MiroslavMitrovic/DashDataDisplay_STM32/Design/PressureSensorTestingAndMeasurements.jpg

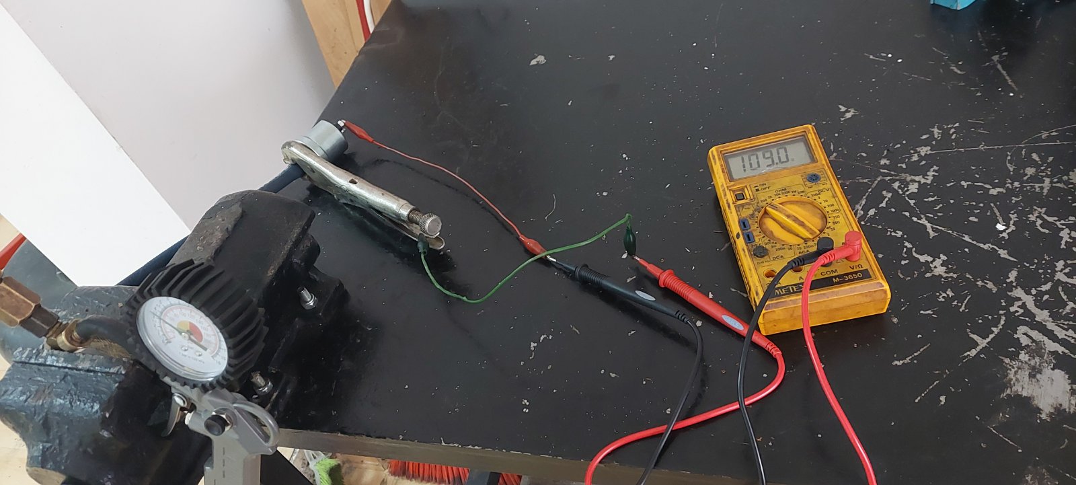
Design/PressureSensorTestingAndMeasurements.jpg
