MiroslavMitrovic/DashDataDisplay_STM32/Hardware/DashDataDisplay/Project Outputs for DashDataDisplay/Net Status - DashDataDisplayPCB.html

Altium customize

# Net Status Report

Date: | | 6/19/2024
Time: | | 10:40:57
Elapsed Time: | | 00:00:01
Filename: | | D:\Projects\git\STM\DashDataDisplay_STM32\Hardware\DashDataDisplay\DashDataDisplayPCB.PcbDoc
Units: | | mmmils

Nets | Layer | Length
+5 | Signal Layers Only | 538.537mm
GND | Signal Layers Only | 1146.7674mm
NetC102_2 | Signal Layers Only | 10.0178mm
NetC112_2 | Signal Layers Only | 10.9581mm
NetC122_2 | Signal Layers Only | 9.4844mm
NetC12_2 | Signal Layers Only | 12.2366mm
NetC132_2 | Signal Layers Only | 22.3811mm
NetC152_2 | Signal Layers Only | 3.0875mm
NetC215_1 | Signal Layers Only | 9.7537mm
NetC225_1 | Signal Layers Only | 34.9349mm
NetC22_2 | Signal Layers Only | 8.9749mm
NetC235_2 | Signal Layers Only | 112.516mm
NetC32_2 | Signal Layers Only | 12.539mm
NetC35_1 | Signal Layers Only | 27.2767mm
NetC37_1 | Signal Layers Only | 128.4952mm
NetC37_2 | Signal Layers Only | 65.4609mm
NetC42_2 | Signal Layers Only | 8.9085mm
NetC45_1 | Signal Layers Only | 23.3635mm
NetC47_1 | Signal Layers Only | 83.8395mm
NetC47_2 | Signal Layers Only | 81.1876mm
NetC52_2 | Signal Layers Only | 12.5202mm
NetC55_1 | Signal Layers Only | 9.926mm
NetC62_2 | Signal Layers Only | 8.3312mm
NetC72_2 | Signal Layers Only | 184.9554mm
NetC75_1 | Signal Layers Only | 41.1927mm
NetC82_2 | Signal Layers Only | 155.3025mm
NetC92_2 | Signal Layers Only | 9.3946mm
NetD11_1 | Signal Layers Only | 3.7163mm
NetD16_1 | Signal Layers Only | 2.9565mm
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
NetU15_16 | Signal Layers Only | 63.1158mm
NetU15_17 | Signal Layers Only | 57.4768mm
NetU15_18 | Signal Layers Only | 92.7663mm
NetU15_33 | Signal Layers Only | 153.1815mm
VBAT | Signal Layers Only | 265.9646mm
VCC | Signal Layers Only | 666.7312mm

Back to top
