MiroslavMitrovic/DashDataDisplay_STM32/Design/ArchitectureDiagrams/HWLayoutSystemDeploymentDiagram.pdf

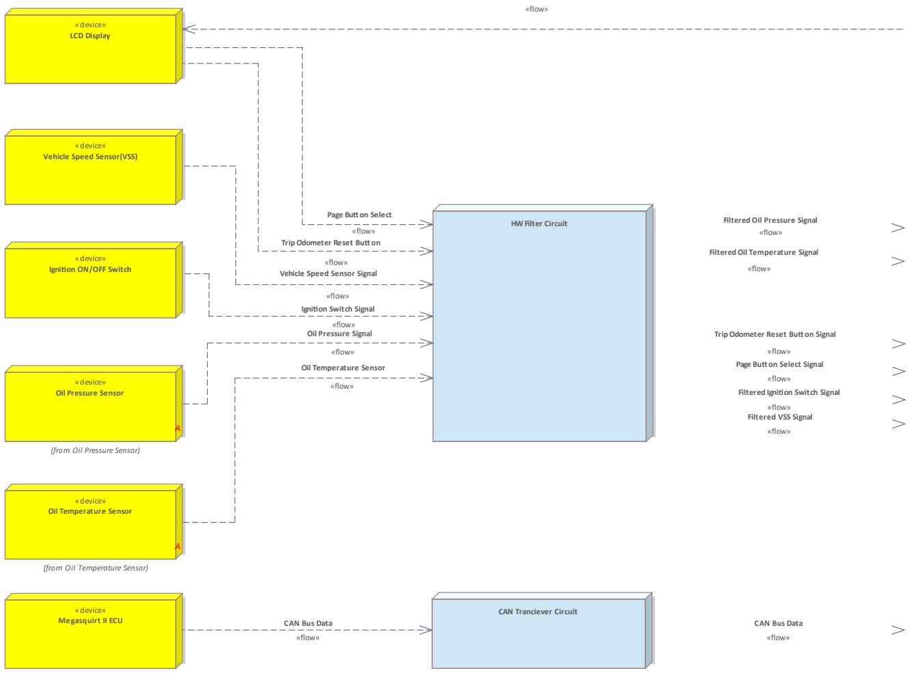
[picture p8: figure]
«device» LCD Display; «device» Vehicle Speed Sensor(VSS); «device» Ignition ON/OFF Switch; «device» Oil Pressure Sensor; (from Oil Pressure Sensor); «device» Oil Temperature Sensor; (from Oil Temperature Sensor); «device» Megasquirt II ECU; HWFilter Circuit; CAN Tranciever Circuit; CAN Bus Data «flow»; Oil Pressure Signal; «flow»; TripOdometer Reset Button; Ignition Switch Signal; Filtered Ignition Switch Signal «flow»; FilteredOil Pressure Signal «flow»; Page Button Select; FilteredOil Temperature Signal; Filtered VSS Signal «flow»; Page Button Select Signal «flow»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

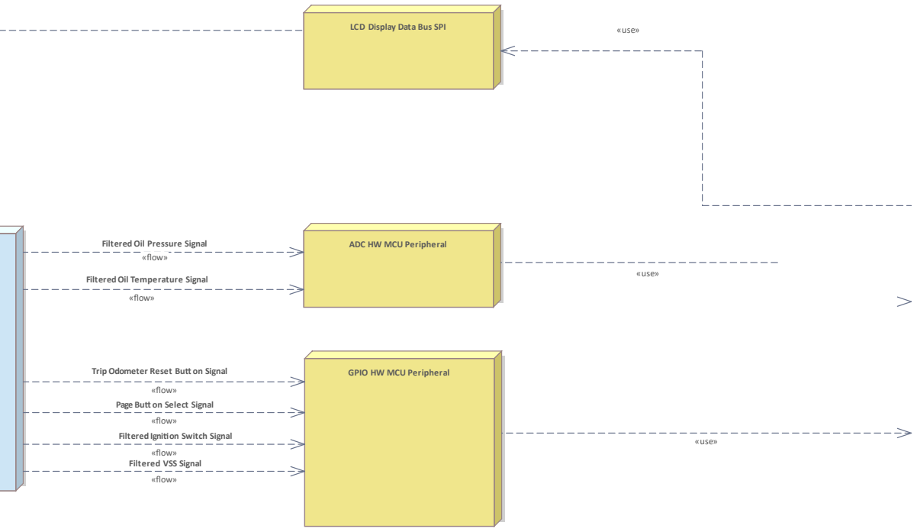
[picture p9: figure]
ADC HW MCU Peripheral; GPIO HW MCU Peripheral; LCD Display Data Bus SPI; «use»; Filtered Ignition Switch Signal «flow»; FilteredOil Pressure Signal «flow»; FilteredOil Temperature Signal; «flow»; Filtered VSS Signal «flow»; Page Button Select Signal «flow»; TripOdometer Reset Button Signal

CAN HW MCU peripheral; CAN Bus Data «flow»; CAN Bus Data «use»
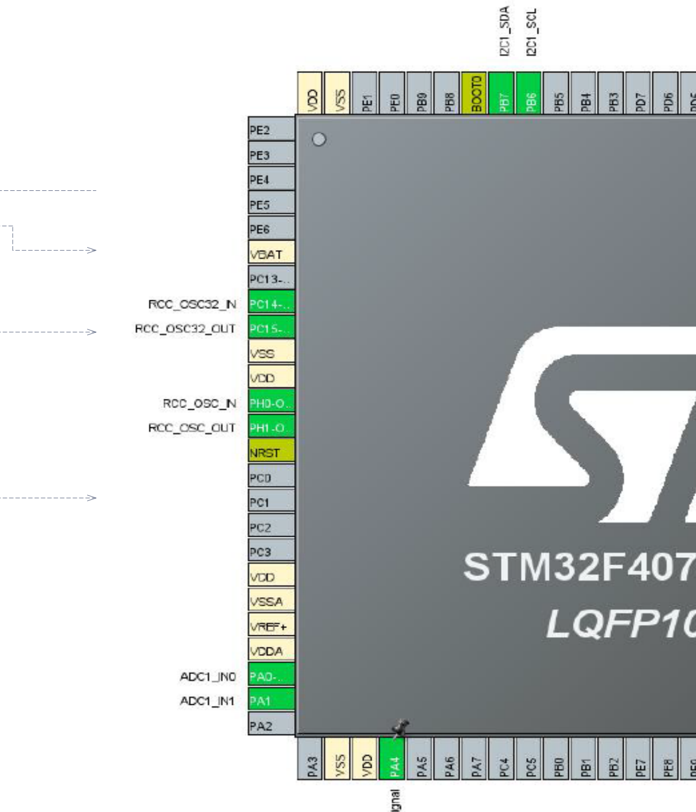
[picture p10: page 3]
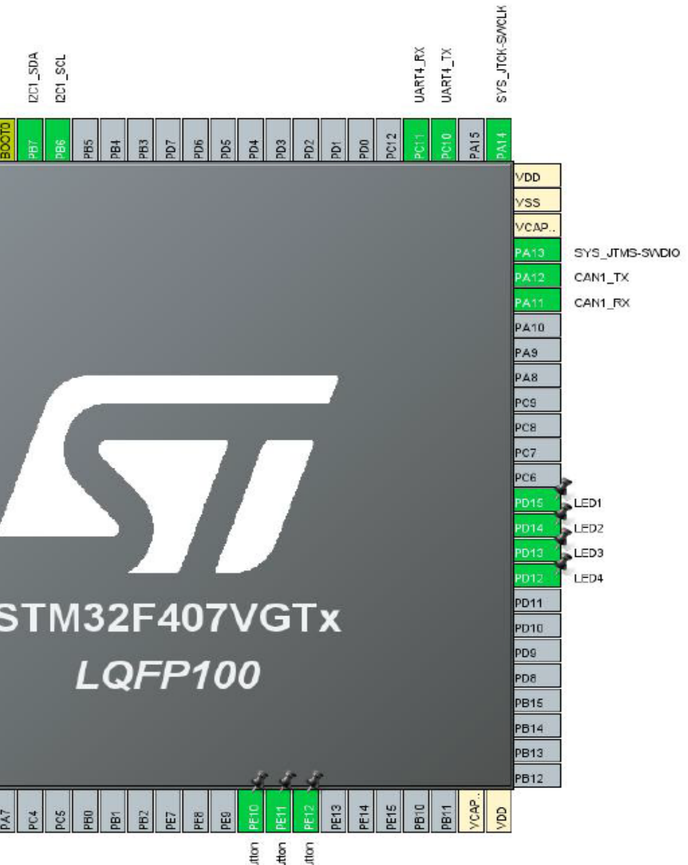
[picture p11: page 4]

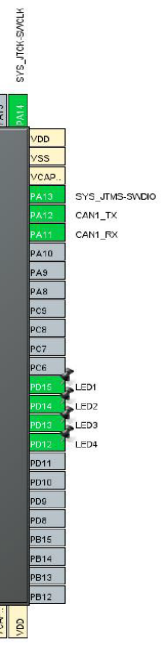
[picture p12: figure]

Legend :
Gold color is for external Components Bluecolor is for external HW peripheral circuits Yellowcolor is for internal MCUHW Peripherals

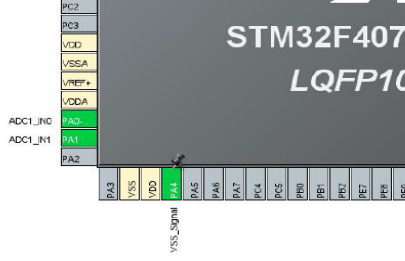
[picture p13: figure]

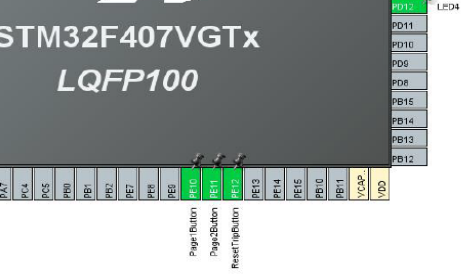
[picture p14: figure]
