MiroslavMitrovic/DashDataDisplay_STM32/Hardware/DashDataDisplay/02_Docs/Connector/ENG_SS_408-3284_A.pdf

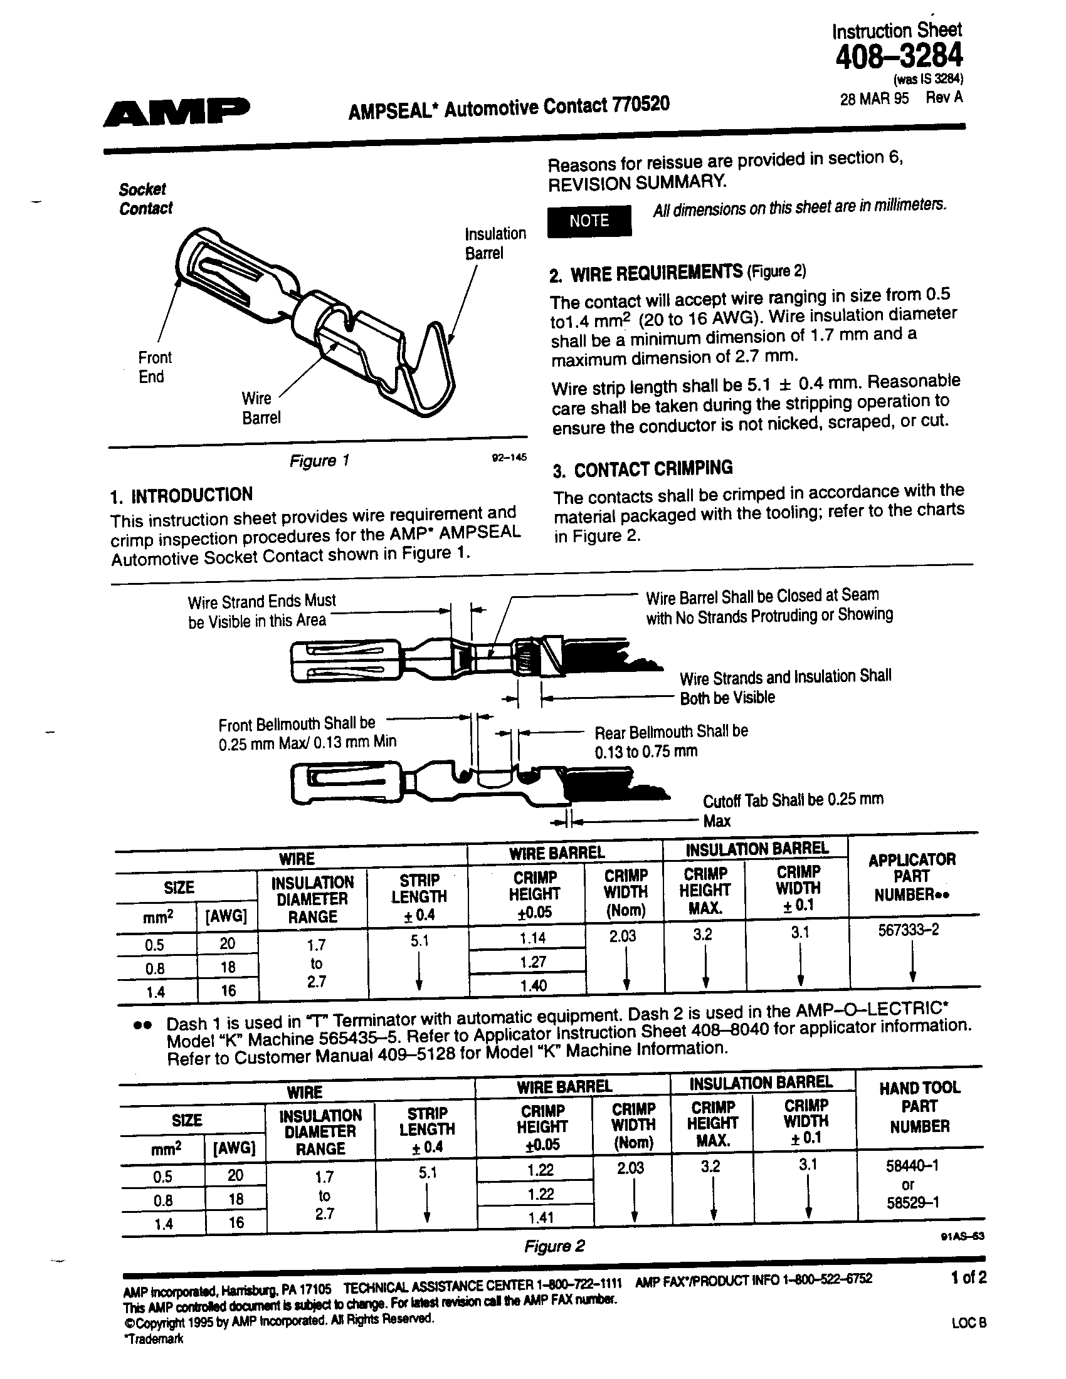
[picture p20: page 1]
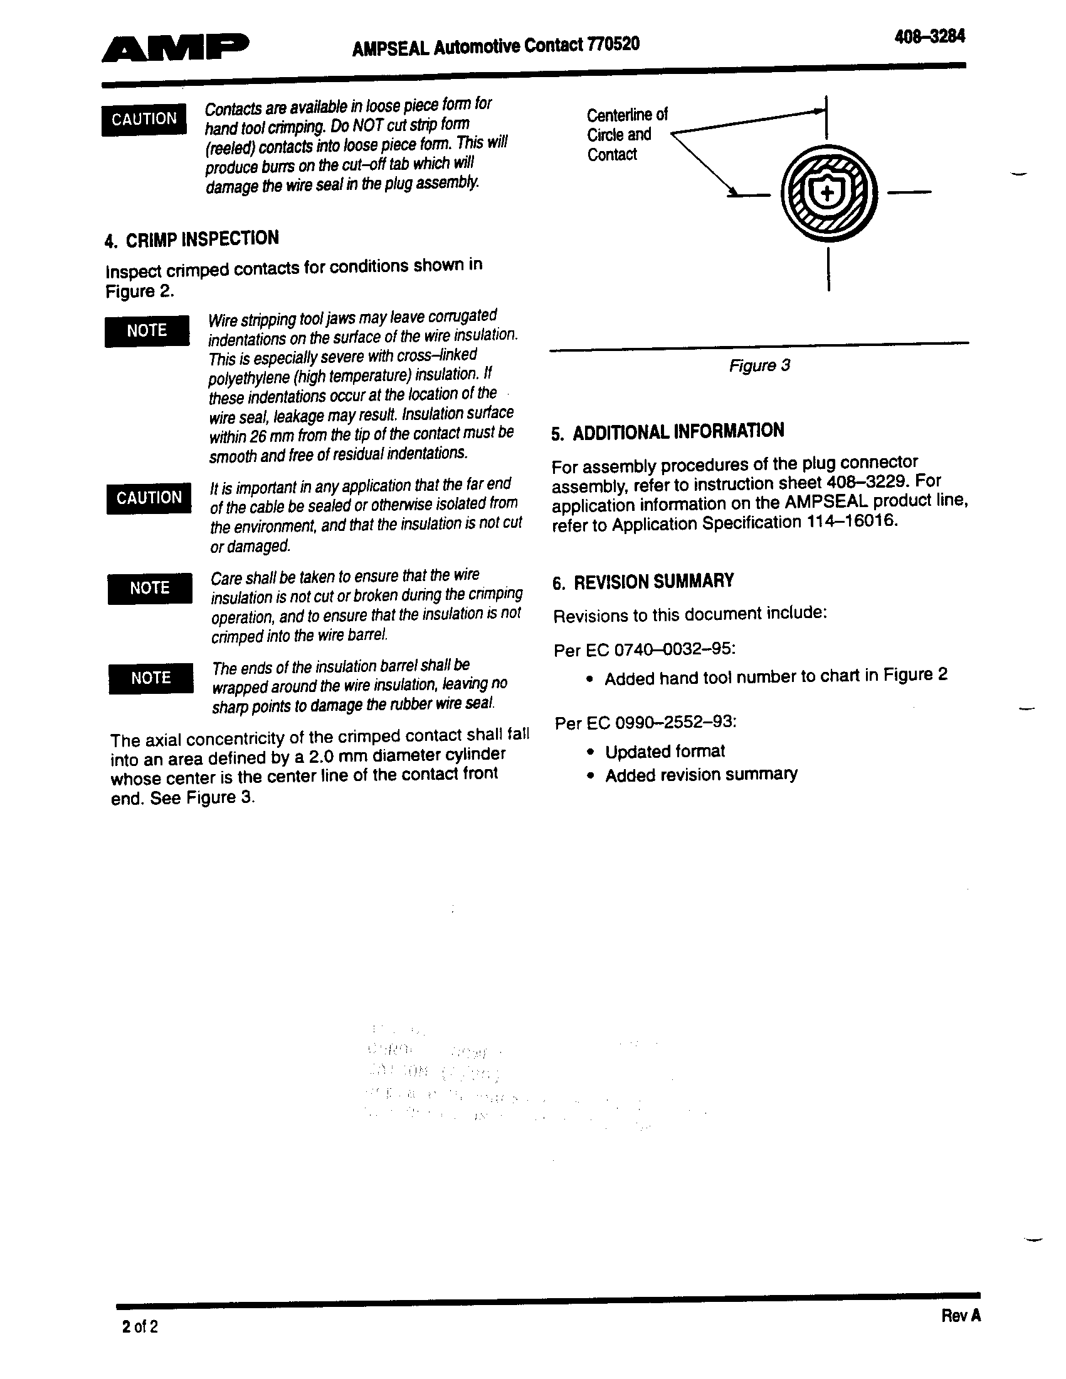
[picture p21: page 2]
