MiroslavMitrovic/DashDataDisplay_STM32/Design/0261230365_bosch_oil_pressureSensor.jpg

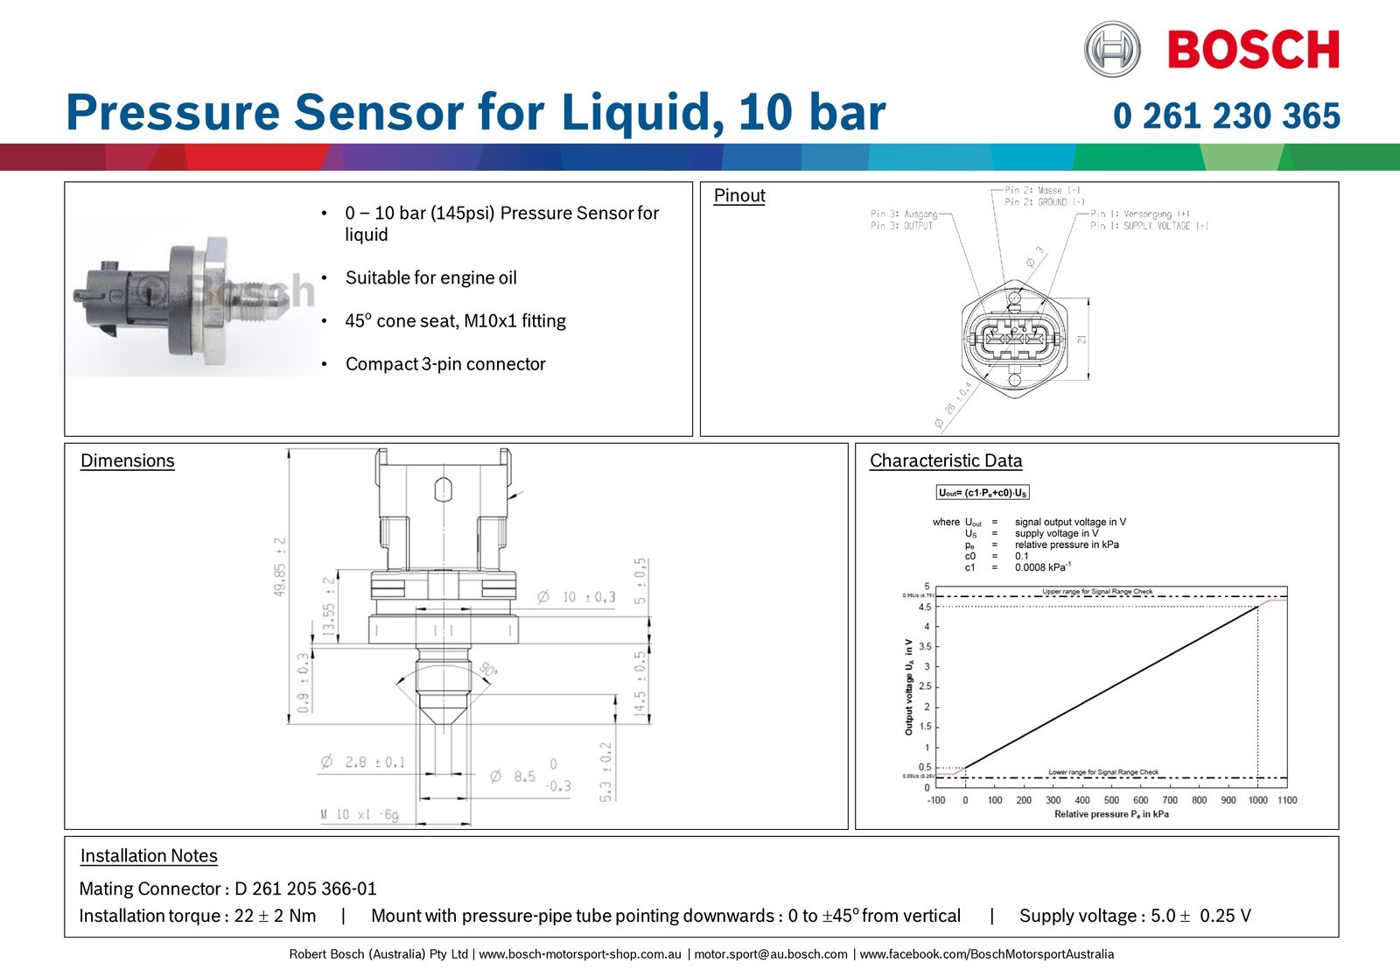
Design/0261230365_bosch_oil_pressureSensor.jpg
