MiroslavMitrovic/DashDataDisplay_STM32/Design/ArchitectureDiagrams/DashDataDisplay_FileStructureDiagram.png

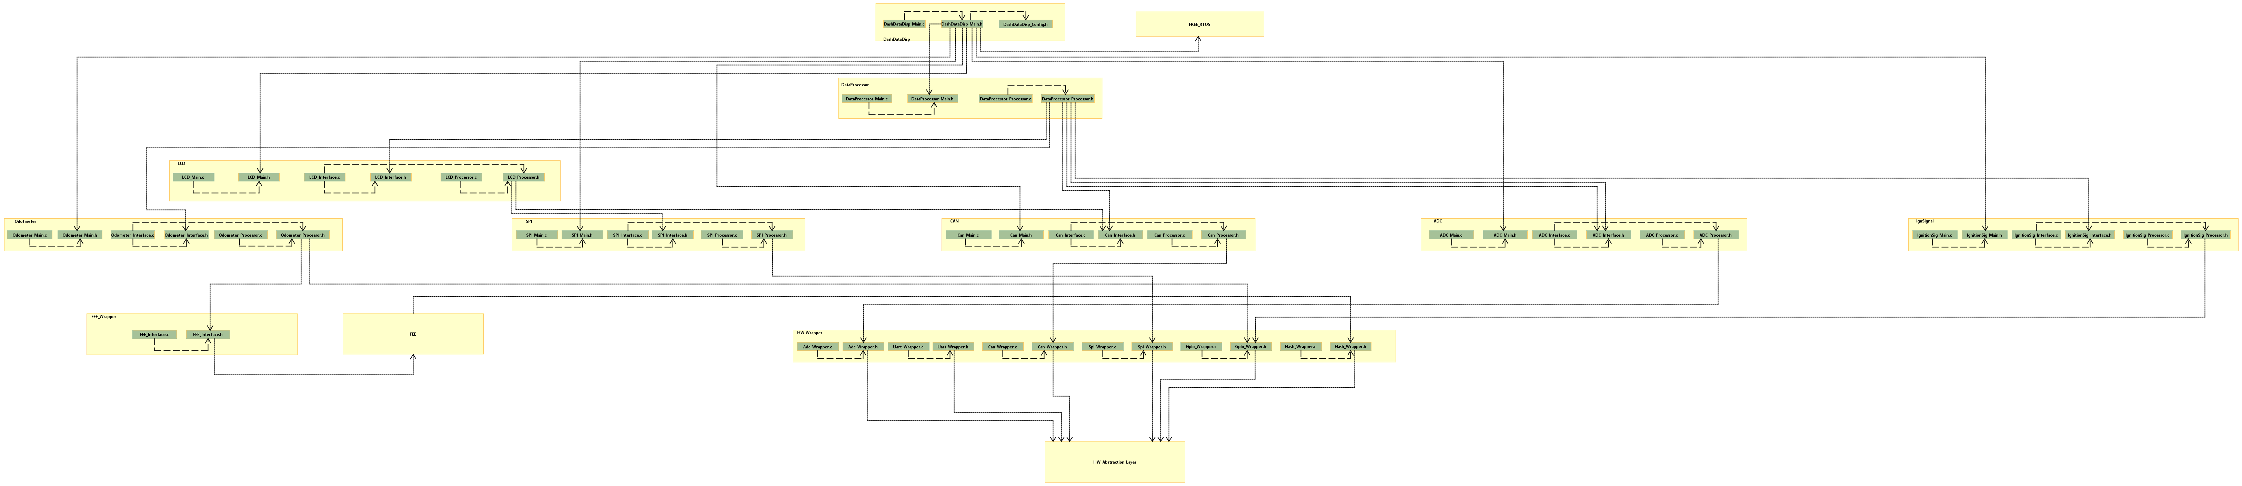
Design/ArchitectureDiagrams/DashDataDisplay_FileStructureDiagram.png
