MiroslavMitrovic/DashDataDisplay_STM32/Design/ArchitectureDiagrams/DashDataDisplay_HW_LayoutSystemDiagram.png

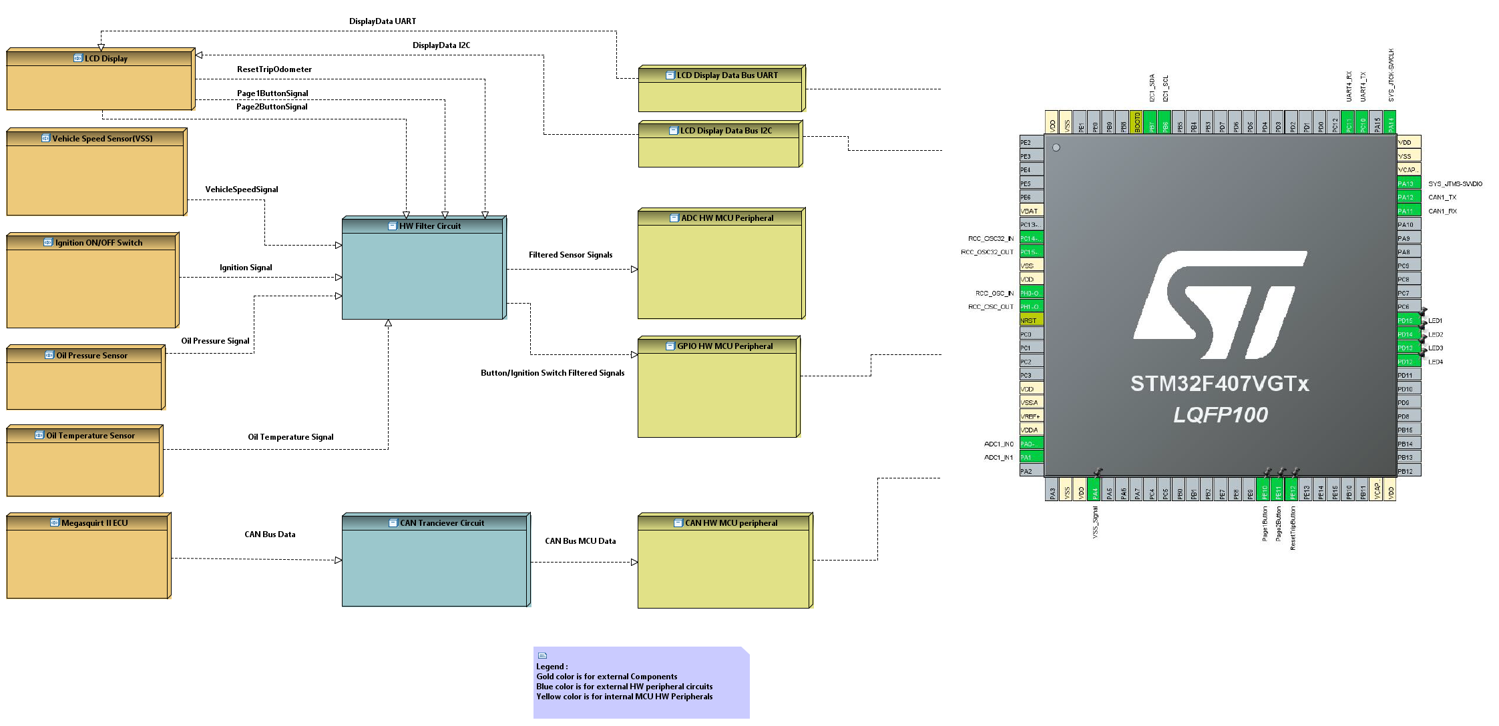
Design/ArchitectureDiagrams/DashDataDisplay_HW_LayoutSystemDiagram.png
