MiroslavMitrovic/DashDataDisplay_STM32/Design/ArchitectureDiagrams/DashDataDisplay_MCUPinLayout.PNG

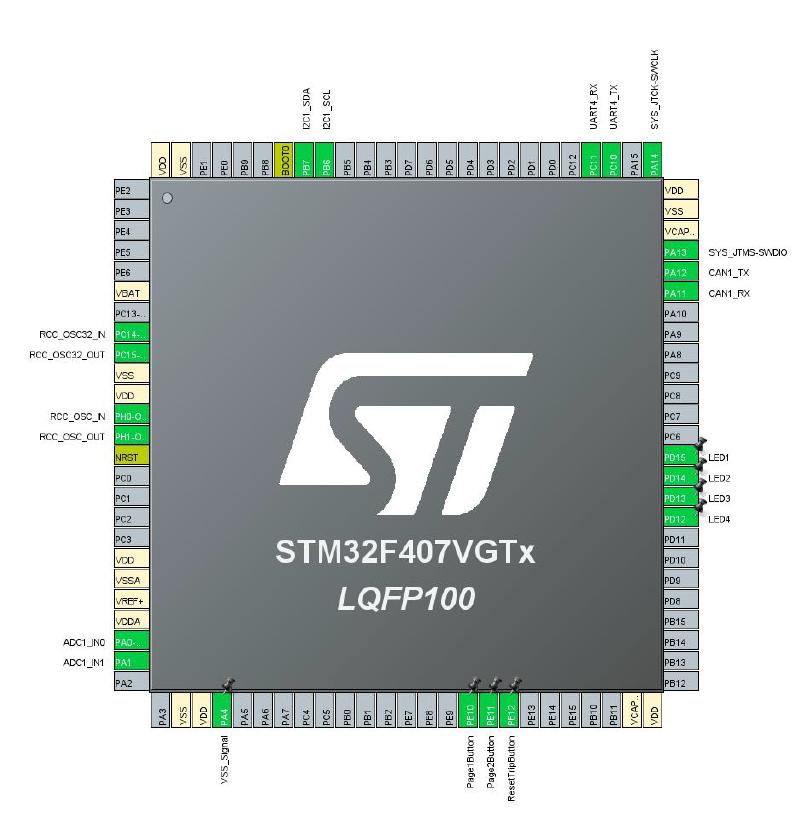
Design/ArchitectureDiagrams/DashDataDisplay_MCUPinLayout.PNG
