MiroslavMitrovic/DashDataDisplay_STM32/Design/ArchitectureDiagrams/ThermistorCalculator.png

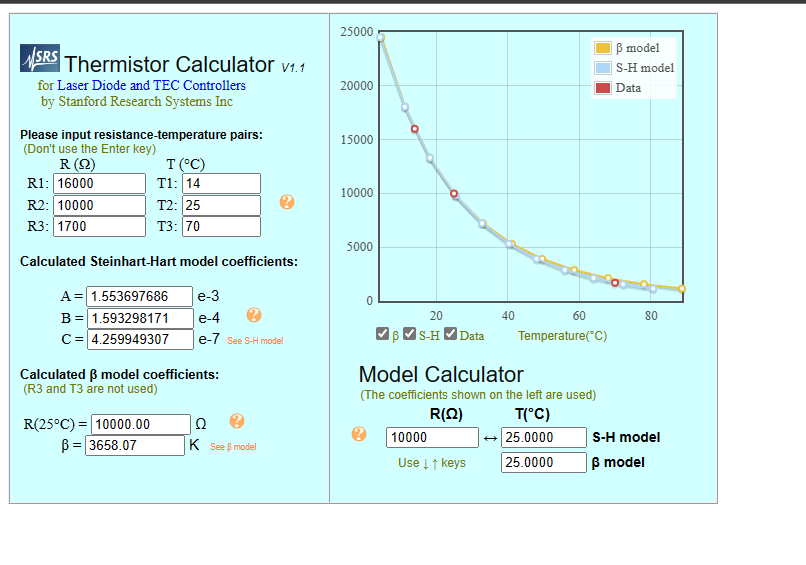
Design/ArchitectureDiagrams/ThermistorCalculator.png
