MiroslavMitrovic/DashDataDisplay_STM32/Design/ArchitectureDiagrams/ThermocoupleInterfacingCircuit.png

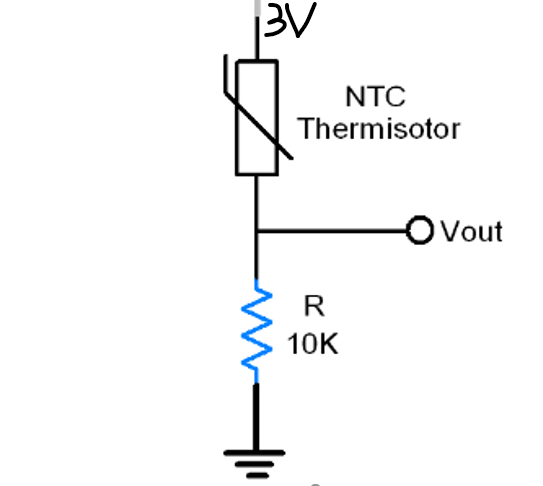
Design/ArchitectureDiagrams/ThermocoupleInterfacingCircuit.png
