MiroslavMitrovic/DashDataDisplay_STM32/Design/NTCcircuitDrawing.png

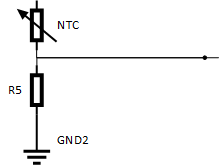
Design/NTCcircuitDrawing.png
