MiroslavMitrovic/DashDataDisplay_STM32/Design/PressureSensorcircuitDrawing.png

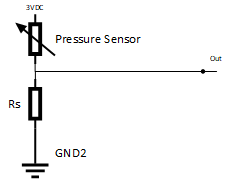
Design/PressureSensorcircuitDrawing.png
