MiroslavMitrovic/DashDataDisplay_STM32/Hardware/DashDataDisplay/02_Docs/MCU/en.mb997_bom/mb997_bom/MB997_B02/MB997-F407VGT6-B02_BOM.xls

MB997 BOM
NO | Code | Part Number | Manufacturer | Description | Designator | Quantity | Process | Note
1 | SQC0001 | TD0341X-G01-BLU | wealthmetal | on-off,Touch switch,Blue,Square head,6*6,SMT,180Degree，TD-0341X-GO1,wealthmetal | B1 | 1 | SMT
2 | AKG0002 | PB-512 Blue | szalong | Button hat,Blue，MB672 | B1-1 | 1 | ASS
3 | SQC0002 | TD0341X-G01-BLA | wealthmetal | open/off,Touch switch,Black,Square head,6*6,SMT,180Degree，TD-0341X-GO1,wealthmetal | B2 | 1 | SMT
4 | AKG0003 | PB-512 Black | szalong | Button hat,Black，MB672 | B2-1 | 1 | ASS
5 | CCC0201 | CC0603KRX7R9BB223 | YAGEO | Capacitance,22nF,10%,50V,X7R,0603 | C54,C55 | 2 | SMT
6 | CCC0008 | CC0603JRNPO9BN151 | YAGEO | Capacitance,150pF,0603,50V,5%,NPO | C46,C48 | 2 | SMT
7 | CCC0100 | CC0603KRX5R5BB106 | YAGEO | Capacitance,10uF,0603,6.3V,20%,X5R | C58 | 1 | SMT
9 | CCC0149 | CC0402JRNPO9BN200 | YAGEO | Capacitance,20pF,5%,50V,NPO,0402,YAGEO | C6,C9 | 2 | SMT
10 | CCC0009 | CC0603KRX5R7BB105 | YAGEO | Capacitance,1uF,0603,16V,10%,X5R,YAGEO | C1,C3,C17,C20,C28,C44,C47,C50,C51,C56,C57 | 11 | SMT
11 | CCC0001 | CC0603KRX7R9BB103 | YAGEO | Capacitance,10nF,0603,50V,10%,X7R,YAGEO; | C5,C13,C52 | 3 | SMT
12 | CCC0049 | CC0603JRNPO9BN200 | YAGEO | Capacitance,20pF,5%,50V,NPO,0603,YAGEO | C14,C15 | 2 | SMT
13 | CTD0045 | TAJA105K016R | AVX | Tantalum capacitor,1uF,10%,16V,typeA,AVX | C22,C23,C59 | 3 | SMT
15 | CTD0004 | TAJA475K016R | AVX | Tantalum capacitor,4.7uF,10%,16V,A tpy,AVX | C49 | 1 | SMT
16 | JEJ0002 | ST-225-02 | townes | Earphone jack，Black，90Degree，Side insert，ST-225-02,wealthmetal; | CN4 | 1 | DIP
17 | JPZ0015 | 313140S212116 | LWCONN | Row,2.54mm,1*6,L=11.6,180Degree,1UGold,DIP,LWCONN | CN2 | 1 | DIP
18 | JPZ0015 | 313140S212116 | LWCONN | Row,2.54mm,1*4,L=11.6,180Degree,1UGold,DIP,LWCONN | CN3 | 1 | DIP
19 | JUS0021 | MUSB5QS-BM1H6-NLB-E | townes | USB,MUSB5QS-BM1H6-NLB-E,townes | CN1 | 1 | SMT
20 | JUS0008 | 47590-0001 | Molex | Socket,USB-AB,47590-0001,SMT,MOLEX,MB784 | CN5 | 1 | SMT
21 | JPZ0033 | 313140S212145 | LWCONN | Row,2.54mm,1*2P,180Degree,L=14.5,1UGold,DIP,LWCONN；High temperature resistant，PA-9T | JP2,JP3 | 2 | SMT
22 | JPZ0015 | 313140S212116 | LWCONN | Row,2.54mm,1*2P,L=11.6,180Degree,1UGold,DIP,LWCONN | JP1 | 1 | DIP
23 | LCZ0006 | FCM1608KF-601T03 | Tai-tech | bead,600R,350mA,0603,FCM1608KF-601T03,Tai-tech | L1 | 1 | SMT
24 | DLD0028 | 19-213SY6C/S530-E2/TR8LED | EVERLIGHT | LED,Green,0603 | LD4,LD7 | 2 | SMT
25 | DLD0030 | 19-217/S2C-AM2N2VY/3T | EVERLIGHT | LED,Orange,0603 | LD3 | 1 | SMT
26 | DLD0027 | 19-213-R6C-AP1Q2B-3T | EVERLIGHT | LED,Red,0603 | LD2,LD5,LD8 | 3 | SMT
27 | DLD0029 | 19-217/BHC-ZL1M2RY/3T | EVERLIGHT | LED,Blue,0603, | LD6 | 1 | SMT
28 | DLD0032 | Avago,HSMF-A201-A00J1 | EVERLIGHT | LED,Red-green，3.2 mm x 2.8 mm,SMT, | LD1 | 1 | SMT
29 | JPZ0052 | 313250S212145 | LWCONN | Row,2.54,2*25/L=14.5/180Degree,1uGold,MB997 | P1,P2 | 2 | SMT
30 | RRC0234 | RC0603FR-0751RL | YAGEO | Resistance,51R,0603,1%，YAGEO | R61,R62 | 2 | SMT
32 | RRC0359 | RC0402FR-07100KL | YAGEO | Resistance，100K,0402,1% | R7,R8,R18,R44,R52 | 5 | SMT
33 | RRC0146 | RC0603FR-071K2L | YAGEO | Resistance,1.2K,0603,1% | R54 | 1 | SMT
34 | RRC0123 | RC0402FR-07100RL | YAGEO | Resistance,100R,0402,1%，YAGEO | R3,R4,R38,R47,R53,R69 | 6 | SMT
 | RRC0034 | RC0603FR-07100RL | YAGEO | Resistance,100R,0603,1% | R68 | 1 | SMT
35 | RRC0080 | RC0603FR-07220KL | YAGEO | Resistance,220K,0603,1% | R39 | 1 | SMT
36 | RRC0055 | RC0603FR-07510RL | YAGEO | Resistance,510R,0603,1% | R30,R32,R40 | 3 | SMT
37 | RRC0041 | RC0603FR-07680RL | YAGEO | Resistance,680R,0603,1% | R36,R41,R42 | 3 | SMT
38 | RRC0128 | RC0402FR-0722RL | YAGEO | Resistance,22R,0402,1%，YAGEO | R12,R15,R16,R17,R58,R60 | 6 | SMT
39 | RRC0130 | RC0402FR-074K7L | YAGEO | Resistance,4.7K,0402,1% | R19,R20,R29,R33 | 4 | SMT
40 | RRC0126 | RC0402FR-071KL | YAGEO | Resistance,1K,0402,1% | R14 | 1 | SMT
41 | RRC0223 | RC0402FR-071K5L | YAGEO | Resistance,1.5K,0402,1%，YAGEO | R9,R37 | 2 | SMT
43 | RRC0014 | RC0603FR-07220RL | YAGEO | Resistance,220R,0603,1% | R24 | 1 | SMT
44 | RRC0258 | RC0603FR-0747RL | YAGEO | Resistance,47R,0603,1%，YAGEO | R23 | 1 | SMT
45 | RRC0540 | RC0603FR-07620RL | YAGEO | Resistance，620R,0603,1% | R67 | 1 | SMT
46 | RRC0313 | RC0402FR-0747KL | YAGEO | Resistance,47K,0402,1% | R51,R56 | 2 | SMT
47 | RRC0065 | RC0603FR-07330RL | YAGEO | Resistance,330R,0603,1% | R66,R35 | 2 | SMT
49 | XWY0022 | HC-49S-C20QSA-8.000MHZ | jfvny | Crystal oscillator，8M，20PF，20PPM,-10-70Degree,DIP,HC-49S | X1,X2 | 2 | DIP
50 | QSJ0002 | MMBT9013 | unisonic | Triode,MMBT9013L,SOT-23,unisonic | T1 | 1 | SMT
51 | UIC0119 | CS43L22 | Cirrus | IC,DAC,CS43L22-CNZ,QFN-40,Cirrus Logic Inc | U7 | 1 | SMT
52 | ST-DEJ0010 | BAT60JFILM | ST | Diode,BAT60JFILM,SOD323/A,ST,(X3 Code 9151097) | D1,D2,D3 | 3 | SMT
53 | ST-UIC0571 | MP45DT02 | ST | IC,MP45DT02 | U9 | 1 | SMT
54 | ST-UIC0051 | LIS302DL | ST | IC,Motion sensor,LIS302DL,LGA14(3*5),ST,(X3 Code 9177944) | U5 | 1 | SMT
55 | ST-UIC0107 | STM32F103C8T6 | ST | IC,STM32F103C8T6(2-2),48-LQFP,ST,(X3 Code9175981) | U2 | 1 | SMT
56 | ST-UIC0036 | LD3985M33R | ST | IC,3.3V,LD3985M33R,SOT23-5L,ST,(X3 Code 9176161) | U1 | 1 | SMT
57 | ST-UIC0572 | LD3985M25R | ST | IC,LD3985M25R,SOT23-5L,ST | U3 | 1 | SMT
58 | ST-UIC0573 | STM32F407VGT6 | ST | IC,STM32F407VGT6 | U4 | 1 | SMT
59 | ST-UIC0095 | STMPS2141STR | ST | IC,STMPS2141STR,SOT23-5,ST,(X3 Code9159003) | U6 | 1 | SMT
60 | ST-UIC0063 | EMIF02-USB03F2 | ST | IC，EMIF02-USB03F2，flip ship，ST,(X3 Code 9179037) | U8 | 1 | SMT
61 | A01D028 | PCB MB997 | FASTPRINT | PCB,MB997 |  | 1 | SMT
62 | ADL0002 | 316102S111A | LWCONN | Short circuit at,2.54MM,开口,1UGold,LWCONN；Harwin,M7566-05/M7571-05 |  | 5 | ASS
63 | PKZ0015 | insert card |  | Paper jam，MB997 B-02 The new version of ST color card |  | 1 | ASS
64 | PXS0007 | Blister |  | Plastic box,MB997 400*140MM PET 0.5MM |  | 1 | ASS
65 | PSD0001 | label |  | Label，White background，6mm,8m |  | 1 | ASS
70 | PBQ0016 |  |  | Test label，Step T1,T2,T3,T4,QA,Look at the objects |  | 1 | ASS
71 | PZX0006 |  |  | Box，L620*425*310mm，MB672 Big box |  | 1/180 | 包装
8 | CCC0071 | CC0402KRX7R7BB104 | YAGEO | Capacitance,100nF,10%,16V,X7R,0402，YAGEO | C2,C4,C7,C8,C10,C11,C12,C18,C19,C21,C24,C25,C26,C29,C30,C31,C32,C34,C35,C37,C39,C40,C41,C42,C43,C45,C53,C60 | 28 | SMT | C38 not Fitted 2011-8-24
14 | CCC0135 | CC1206KKX7R7BB225 | YAGEO | Capacitance,2.2uF,10%,16V,X7R,1206 | C33,C36 | 2 | SMT | modified TAN-A to 1206，2011-11-11 sunnash
31 | RRC0124 | RC0402FR-0710KL | YAGEO | Resistance,10K,0402,1%，YAGEO | R5,R6,R13,R31,R34,R43,R45 | 7 | SMT | R64 not Fitted 2011-8-24
42 | RRC0030 | RC0603JR-070RL | YAGEO | Resistance,0R,0603,5%,YAGEO | R1,R10,R11,R21,R22,R25,R26,R28,R46,R48,R50,R55,R59,R65 | 14 | SMT | delete R27,add R28,2012-1-6
48 | RRC0220 | RC0402JR-070RL | YAGEO | Resistance,0R,0402,5%，YAGEO | SB1,SB3,SB5,SB7,SB9,SB11,SB12,SB15,SB16,SB18,SB19,SB20,R63 | 13 | SMT | R63 modified to 0R，0402 2011-8-24
