MiroslavMitrovic/DashDataDisplay_STM32/Hardware/DashDataDisplay/02_Docs/MCU/en.mb997_bom/mb997_bom/MB997_D01/MB997-F407VGT6-D01_BOM.xls

Sheet: BOM Report
Bill of Materials |  |  |  | STMicroelectronics
Project: |  | STM32F407G-DISC1
Board Name |  | MB997
Board Version |  | D-01
Variant: |  | None
Creation Date: | 11/6/2015 | 11:05:01 AM
Print Date: | 2015-11-06 | 11:06:12
Comment | Description | Designator | Fitted | Solder | Footprint | Manuf_1 | Manuf_Part_1 | Quantity
SW-PUSH-CMS | Non-Open Push-Button 0.1A 24V | B1, B2 |  |  | BP1CMS | FARNELL | 535-930 | 2
1µF_X5R_0603 | 0603 X5R 1µF | C1, C3, C17, C20 |  |  | 0603C |  |  | 4
100nF | Capacitor | C2, C4, C18, C19, C21, C24, C25, C26, C29, C30, C31, C32, C34, C35, C37, C38, C60 | NO |  | 0603C |  |  | 17
10nF_X7R_0603 | 0603 X7R 10NF | C5, C13 |  |  | 0603C |  |  | 2
20pF | Capacitor | C6, C9, C61 | NO |  | 0402C |  |  | 3
100nF | Capacitor | C7, C8, C10, C11, C12, C39 |  |  | 0402C |  |  | 6
20pF | Capacitor | C14, C15 |  |  | 0603C |  |  | 2
6.8pF | Capacitor | C16, C27 | NO |  | 0603C |  |  | 2
1uF | Polarized Capacitor (Radial) | C22, C23 |  |  | CASE-AA |  |  | 2
1uF | Capacitor | C28 |  |  | 0603C |  |  | 1
2.2uF | Low ESR Ceramic Capacitor (X7R) | C33, C36 |  |  | CASE-A |  |  | 2
0.1uF | Capacitor | C40, C41, C42, C43, C45, C53 |  |  | 0402C |  |  | 6
1uF(X7R) | Capacitor | C44, C47, C51 |  |  | 0603C |  |  | 3
150pF(COG) | Capacitor | C46, C48 |  |  | 0603C |  |  | 2
4.7uF | Polarized Capacitor (Radial) | C49 |  |  | TAN-A |  |  | 1
1uF (X7R) | Capacitor | C50 |  |  | 0603C |  |  | 1
10nF | Capacitor | C52 |  |  | 0603C |  |  | 1
0.022uF | Capacitor | C54, C55 |  |  | 0603C |  |  | 2
1uF(X5R) | Capacitor | C56, C57 |  |  | 0603C |  |  | 2
10uF | Capacitor | C58 |  |  | 0603C |  |  | 1
1uF | Polarized Capacitor (Radial) | C59 |  |  | TAN-A |  |  | 1
5075BMR-05-SM |  | CN1 |  |  | USB-MINI-B-SMD |  |  | 1
Header 6 | Header, 6-Pin | CN2 |  |  | HDR1X6 |  |  | 1
Header 4 | Header, 4-Pin | CN3 |  |  | Header 4 |  |  | 1
ST-225-02 | Connector Jack 35mm | CN4 |  |  | Jack-ST-225 | XIEJIA Electronics | ST-225-02 | 1
475900001 |  | CN5 |  |  | USB-MICRO-AB |  |  | 1
BAT60JFILM | BAT60JFILM | D1, D2, D3 |  |  | SOD323/A | STM | BAT60JFILM | 3
 |  | JP1, JP2, JP3 |  |  | SIP2/2.54 |  |  | 3
fcm1608-0603 | Inductor | L1 |  |  | 0603L |  |  | 1
LD_BICOLOR_CMS | Bicolor Led | LD1 |  |  | HSMF-A201 | Avago Technologies | HSMF-A201-A00J1 | 1
RED | Typical RED, GREEN, YELLOW, AMBER GaAs LED | LD2, LD5, LD8 |  |  | 0603D |  |  | 3
Orange | Typical RED, GREEN, YELLOW, AMBER GaAs LED | LD3 |  |  | 0603D |  |  | 1
Green | Typical RED, GREEN, YELLOW, AMBER GaAs LED | LD4, LD7 |  |  | 0603D |  |  | 2
Blue | Typical RED, GREEN, YELLOW, AMBER GaAs LED | LD6 |  |  | 0603D |  |  | 1
Header 25X2 | Header, 25-Pin, Dual row | P1, P2 |  |  | HDR2X25 |  |  | 2
0 | Resistor | R1, R48, R49, R55, R63, R64, R65 | NO |  | 0402R |  |  | 7
100 | Resistor | R2, R3, R4, R38, R68, R69 | NO |  | 0402R |  |  | 6
10K | Resistor | R5, R6, R13, R34, R43, R45 | NO |  | 0402R |  |  | 6
100K | Resistor | R7, R8, R18, R37, R44, R52 | NO |  | 0402R |  |  | 6
1K5 | Resistor | R9 |  |  | 0402R |  |  | 1
0 | Resistor | R10, R11, R21, R22, R25, R28, R46, R50, R59 | NO |  | 0603R |  |  | 9
22 | Resistor | R12, R15, R16, R17 |  |  | 0402R |  |  | 4
1K | Resistor | R14 |  |  | 0402R |  |  | 1
4K7 | Resistor | R19, R20 |  |  | 0402R |  |  | 2
47 | Resistor | R23 |  |  | 0603R |  |  | 1
220 | Resistor | R24 |  |  | 0603R |  |  | 1
[N/A] | Resistor | R26, R27, R57 | NO |  | 0603R |  |  | 3
4.7K | Resistor | R29, R33 |  |  | 0402R |  |  | 2
510 | Resistor | R30, R32, R40 |  |  | 0603R |  |  | 3
[N/A] | Resistor | R31 | NO |  | 0402R |  |  | 1
330 | Resistor | R35 |  |  | 0402R |  |  | 1
680 | Resistor | R36, R41, R42 |  |  | 0603R |  |  | 3
220K | Resistor | R39 |  |  | 0603R |  |  | 1
100 | Resistor | R47, R53 |  |  | 0603R |  |  | 2
47K | Resistor | R51, R56 |  |  | 0402R |  |  | 2
1.2K | Resistor | R54 |  |  | 0603R |  |  | 1
22 | Resistor | R58, R60 |  |  | 0603R |  |  | 2
51 | Resistor | R61, R62 |  |  | 0603R |  |  | 2
330 | Resistor | R66 |  |  | 0603R |  |  | 1
620 | Resistor | R67 |  |  | 0603R |  |  | 1
Circuit Breaker | Circuit Breaker | SB1, SB2, SB4, SB6, SB8, SB11, SB12, SB14, SB17, SB18, SB20 |  | YES | JP2_SMD |  |  | 11
Circuit Breaker | Circuit Breaker | SB3, SB5, SB7, SB9, SB10, SB13, SB15, SB16, SB19 |  | NO | JP2_SMD |  |  | 9
9013 | NPN Bipolar Transistor | T1 |  |  | SOT-23 |  |  | 1
LD3985M33R | Ultra low drop-low noise BiCMOS voltage, regulators low ESR capacitors compatible | U1 |  |  | SOT-23-5L | STM | LD3985M33R | 1
STM32F103CBT6 | Medium-density performance line ARM-based 32-bit MCU with 128KB Flash | U2 |  |  | QFP48 7x7 | STM | STM32F103CBT6 | 1
LD3985M25R | Ultra low drop-low noise BiCMOS voltage, regulators low ESR capacitors compatible | U3 |  |  | SOT-23-5L | STM | LD3985M25R | 1
STM32F407VGT6 | STM32 Manta (STM32F407VGT6) | U4 |  |  | TQFP100 | STM | STM32F407VGT6 | 1
LIS3DSH | MEMS motion sensor 3-axis - ±2g/±4g/±6g/±8g/±16g digital output accelerometer | U5 |  |  | LGA16(3*3) | STM | LIS3DSHTR | 1
STMPS2141STR | Enhanced single channel power switches | U6 |  |  | SOT23-5L | STM | STMPS2141STR | 1
CS43L22 | Low Power, Stereo DAC w/Headphone & Speaker Amps | U7 |  |  | QFN40 |  |  | 1
EMIF02-USB03F2 | 2-line IPAD, EMI filter including ESD protection | U8 |  |  | Flip Chip | STM | EMIF02-USB03F2 | 1
MP45DT02 | MEMS audio sensor, omnidirectional digital microphone | U9 |  |  | HLGA-4.72-3.76-6LD | STM | MP45DT02 | 1
8MHz | Crystal Oscillator | X1, X2 |  |  | XTAL1 |  |  | 2
MC306-G-06Q-32.768 (manufacturer JFVNY) |  | X3 | NO |  | MC306-CRYSTAL |  |  | 1
 |  |  |  |  |  |  |  | 187

Sheet: Project Information
Project Full Path | M:\bruno_pc\mcd_eval\stm32f407g-disc1\design\mb997\schematics\MB997.PrjPCB
Project Filename | <Parameter Project not found>
Variant Name | None
Data-Source Filename | MB997.PrjPCB
Data-Source Full Path | M:\bruno_pc\mcd_eval\stm32f407g-disc1\design\mb997\schematics\MB997.PrjPCB
Title | <Parameter Title not found>
Total Quantity | 187
Report Time | 11:05:01 AM
Report Date | 11/6/2015
Report Date & Tine | 11/6/2015 11:05:01 AM
Output Name | Bill of Materials
Output Type | BOM_PartType
Output Generator Name | BOM
Board Name | 1
Board Version | D.1(PCB.SCH)
Fitted | <Parameter Fitted not found>
Solder Bridge State | <Parameter Solder not found>
Order | <Parameter Order not found>
Provided by | <Parameter Provided not found>
ST Reference | <Parameter Order not found>
Distributor | <Parameter Distrib not found>
ECCN Code | <Parameter ECCN_US/EU not found>
Order_1 | <Parameter Order_1 not found>
Manufacturer 1 | <Parameter Manuf_1 not found>
Part 1 | <Parameter Manuf_Part_1 not found>
Manufacturer 2 | <Parameter Manuf_2 not found>
Part 2 | <Parameter Manuf_Part_2 not found>
Manufacturer 3 | <Parameter Manuf_3 not found>
Part 3 | <Parameter Manuf_Part_3 not found>
Marking | <Parameter Silkscreen not found>
Order_3 | <Parameter Order_3 not found>
Output Generator Description | Bill of Materials
