MiroslavMitrovic/DashDataDisplay_STM32/Hardware/DashDataDisplay/02_Docs/MCU/en.mb997_bom/mb997_bom/MB997_E01/MB997-F407VGT6-E01_BOM.xlsx

 |  |  | Bill of materials
 |  |  | Board reference: | MB997
 |  |  | Variant: | F407VGT6
 |  |  | PCB revision: | E
 |  |  | Assembly revision: | 01
 |  |  | Date: | 23/04/2020
Designator | Description | Footprint | Manuf_1 | Manuf_Part_1 | Fitted | Solder | Quantity
B1 | Non-Open Push-Button 0.1A 24V | SW4SMD | CHAU-HUA | CTSM-644B-V-T/R | Fitted |  | 1
B2 | Non-Open Push-Button 0.1A 24V | SW4SMD | CHAU-HUA | CTSM-644N-V-T/R | Fitted |  | 1
C1, C3, C17, C20, C28, C44, C47, C50, C51, C56, C57 | 0603 X5R 1µF, Capacitor | 0603C | YAGEO | CC0603KRX5R7BB105 | Fitted |  | 11
C2, C4, C7, C8, C10, C11, C12, C18, C19, C21, C24, C25, C26, C29, C30, C31, C32, C34, C35, C37, C39, C40, C41, C42, C43, C45, C53, C60 | Capacitor | 0402C | YAGEO | CC0402KRX7R7BB104 | Fitted |  | 28
C5, C13, C52 | 0603 X7R 10NF, Capacitor | 0603C | YAGEO | CC0603KRX7R9BB103 | Fitted |  | 3
C6, C9 | Capacitor | 0402C | YAGEO | CC0402JRNPO9BN200 | Fitted |  | 2
C14, C15 | Capacitor | 0603C | YAGEO | CC0603JRNPO9BN200 | Fitted |  | 2
C22, C23, C59 | Polarized Capacitor (Radial) | CASE-A | AVX | TAJA105K016R | Fitted |  | 3
C33, C36 | Low ESR Ceramic Capacitor (X7R) | CASE-A | YAGEO | CC1206KKX7R7BB225 | Fitted |  | 2
C46, C48 | Capacitor | 0603C | YAGEO | CC0603JRNPO9BN151 | Fitted |  | 2
C49 | Polarized Capacitor (Radial) | CASE-A | AVX | TAJA475K016R | Fitted |  | 1
C54, C55 | Capacitor | 0603C | YAGEO | CC0603KRX7R9BB223 | Fitted |  | 2
C58 | Capacitor | 0603C | YAGEO | CC0603KRX5R5BB106 | Fitted |  | 1
CN1 |  | USB-MINI-B-SMD-A_ | MTCONN | UBF-MINI5-03 | Fitted |  | 1
CN2 | Header, 6-Pin | HEADER6$2F$2.54 | LWCONN | 313140S212116 | Fitted |  | 1
CN3 | Header, 4-Pin | HEADER4$2F$2.54 | LWCONN | 313140S212116 | Fitted |  | 1
CN4 | Connector Jack 35mm | PCBCOMPONENT_1$2F$2_new_ | XIEJIA Electronics | ST-225-02 | Fitted |  | 1
CN5 |  | USB-MICRO-AB_new | Molex | 47590-0001 | Fitted |  | 1
D1, D2, D3 | BAT60JFILM | SOD323$2F$A | STM | BAT60JFILM | Fitted |  | 3
HW1 | switch hat,blue |  | CHAU-HUA | KTSC-62B | Fitted |  | 1
HW2 | switch hat,black |  | CHAU-HUA | KTSC-62K | Fitted |  | 1
JP1 |  | SIP2$2F$2.54 | LWCONN | 313140S212116 | Fitted |  | 1
JP2, JP3 |  | SIP2$2F$2.54 | LWCONN | 313140S212145 | Fitted |  | 2
L1 | Inductor | 0603L | Tai-tech | FCM1608KF-601T03 | Fitted |  | 1
LD1 | Bicolor Led | AV02-0501EN | Avago Technologies | HSMF-A201-A00J1 | Fitted |  | 1
LD2, LD5, LD8 | [NoValue], Typical RED, GREEN, YELLOW, AMBER GaAs LED | LED0603 | EVERLIGHT | 19-213-R6C-AP1Q2B-3T | Fitted |  | 3
LD3 | Typical RED, GREEN, YELLOW, AMBER GaAs LED | LED0603 | EVERLIGHT | 19-217/S2C-AM2N2VY/3T | Fitted |  | 1
LD4, LD7 | Typical RED, GREEN, YELLOW, AMBER GaAs LED | LED0603 | EVERLIGHT | 19-213SY6C/S530-E2/TR8LED | Fitted |  | 2
LD6 | Typical RED, GREEN, YELLOW, AMBER GaAs LED | LED0603 | EVERLIGHT | 19-217/BHC-ZL1M2RY/3T | Fitted |  | 1
P1, P2 | Header, 25-Pin, Dual row | HEAD25X2$2F$2.54 | LWCONN | 313250S212145 | Fitted |  | 2
R1, R10, R11, R25, R26, R28, R46, R48, R50, R55, R59, R65 | Resistor | 0603R | YAGEO | RC0603JR-070RL | Fitted |  | 12
R3, R4, R38, R47, R53, R69 | Resistor | 0402R | YAGEO | RC0402FR-07100RL | Fitted |  | 6
R5, R6, R13, R31, R34, R43, R45 | Resistor | 0402R | YAGEO | RC0402FR-0710KL | Fitted |  | 7
R7, R8, R18, R44, R52 | Resistor | 0402R | YAGEO | RC0402FR-07100KL | Fitted |  | 5
R9, R37 | Resistor | 0402R | YAGEO | RC0402FR-071K5L | Fitted |  | 2
R12, R15, R16, R17, R58, R60 | Resistor | 0402R | YAGEO | RC0402FR-0722RL | Fitted |  | 6
R14 | Resistor | 0402R | YAGEO | RC0402FR-071KL | Fitted |  | 1
R19, R20, R29, R33 | Resistor | 0402R | YAGEO | RC0402FR-074K7L | Fitted |  | 4
R23 | Resistor | 0603R | YAGEO | RC0603FR-0747RL | Fitted |  | 1
R24 | Resistor | 0603R | YAGEO | RC0603FR-07220RL | Fitted |  | 1
R30, R32, R40 | Resistor | 0603R | YAGEO | RC0603FR-07510RL | Fitted |  | 3
R35, R66 | Resistor | 0603R | YAGEO | RC0603FR-07330RL | Fitted |  | 2
R36, R41, R42 | Resistor | 0603R | YAGEO | RC0603FR-07680RL | Fitted |  | 3
R39 | Resistor | 0603R | YAGEO | RC0603FR-07220KL | Fitted |  | 1
R51, R56 | Resistor | 0402R | YAGEO | RC0402FR-0747KL | Fitted |  | 2
R54 | Resistor | 0603R | YAGEO | RC0603FR-071K2L | Fitted |  | 1
R61, R62 | Resistor | 0603R | YAGEO | RC0603FR-0751RL | Fitted |  | 2
R63 | Resistor | 0402R | YAGEO | RC0402JR-070RL | Fitted |  | 1
R67 | Resistor | 0603R | YAGEO | RC0603FR-07620RL | Fitted |  | 1
R68 | Resistor | 0603R | YAGEO | RC0603FR-07100RL | Fitted |  | 1
SB1, SB3, SB5, SB7, SB9, SB11, SB12, SB15, SB16, SB18, SB20 | Circuit Breaker | JUMPER |  |  | Fitted | YES | 11
T1 | NPN Bipolar Transistor | SOT23 | unisonic | MMBT9013 | Fitted |  | 1
U1 | Ultra low drop-low noise BiCMOS voltage, regulators low ESR capacitors compatible | SOT-23-5L | STM | LD3985M33R | Fitted |  | 1
U2 | Medium-density performance line ARM-based 32-bit MCU with 128KB Flash | LQFP48$2F$0.5MM$5C$9X9B | STM | STM32F103CBT6 | Fitted |  | 1
U3 | Ultra low drop-low noise BiCMOS voltage, regulators low ESR capacitors compatible | SOT-23-5L | STM | LD3985M25R | Fitted |  | 1
U4 | STM32 Manta (STM32F407VGT6) | QFP100-1414 | STM | STM32F407VGT6 | Fitted |  | 1
U5 | MEMS motion sensor 3-axis - ±2g/±4g/±6g/±8g/±16g digital output accelerometer | LGA16_ | STM | LIS3DSHTR | Fitted |  | 1
U6 | Enhanced single channel power switches | SOT-23-5L | STM | STMPS2141STR | Fitted |  | 1
U7 | Low Power, Stereo DAC w/Headphone & Speaker Amps | QFN40(6_6) | Cirrus | CS43L22 | Fitted |  | 1
U8 | 2-line IPAD, EMI filter including ESD protection | FLIPCHIP(11) | STM | EMIF02-USB03F2 | Fitted |  | 1
U9 | MEMS audio sensor omnidirectional digital microphone for industrial applications | MIC_HCLGA_3X4X1_4LD_t | STM | IMP34DT05TR | Fitted |  | 1
X1, X2 | Crystal Oscillator | HC-49A | jfvny | HC-49S-C20QSA-8.000MHZ | Fitted |  | 2
C16, C27, C61 | Capacitor | 0603C |  |  | Not Fitted |  | 0
C38 | Capacitor | 0402C |  |  | Not Fitted |  | 0
R2, R64 | Resistor | 0402R |  |  | Not Fitted |  | 0
R21, R22, R27, R57 | Resistor | 0603R |  |  | Not Fitted |  | 0
R49 | Resistor | 0603R | YAGEO | RC0603JR-070RL | Not Fitted |  | 0
SB2, SB4, SB6, SB8, SB10, SB13, SB14, SB17, SB19 | Circuit Breaker | JUMPER |  |  | Not Fitted | NO | 0
X3 |  | MC306-CRYSTAL |  |  | Not Fitted |  | 0
