MiroslavMitrovic/DashDataDisplay_STM32/Hardware/DashDataDisplay/Project Outputs for DashDataDisplay/DashDataDisplay.xlsx

Line # | Name | Description | Designator | Quantity | Manufacturer 1 | Manufacturer Part Number 1 | Manufacturer Lifecycle 1 | Supplier 1 | Supplier Part Number 1 | Supplier Unit Price 1 | Supplier Subtotal 1
 | EEUFC0J101 | No Description Available | C11, C21 | 2
 | 0.33µF | CAP CER 0.33UF 16V X7R 0805 | C12, C22, C32, C42, C52, C62, C72, C82, C92, C102, C112, C122, C132, C152 | 14 |  |  |  | DigiKey | 478-5273-1-ND
 | 0.1 µF | CAP CER 0.1UF 16V X7R 0805 | C13, C17, C27, C46, C56, C66 | 6 | Walsin Technologies | 0805B104K160CT | Volume Production | DigiKey | 1292-1565-1-ND
 | 1µF | CAP CER 1UF 6.3V X5R 0805 | C15, C65, C95, C105, C135, C155, C175, C195 | 8 | Kyocera AVX | LGC26D105MAT2S1\4K |  | DigiKey | 478-6694-1-ND
 | 1 µF | CAP CER 1UF 16V X7R 0805 | C16, C26, C36 | 3 | Taiyo Yuden | EMK212B7105KGHTR |  | DigiKey | 587-6310-1-ND
 | 0.1µF | CAP CER 0.1UF 6.3V X7R 0805 | C25, C85, C115, C125, C145, C165, C185, C205, C235 | 9 | Kyocera AVX | 08056C104JAZ2A | Volume Production | DigiKey | 478-11914-1-ND
 | EEUFC0J101 | No Description Available | C31, C41 | 2
 | 2.2 µF | CAP CER 2.2UF 6.3V X5R 0805 | C35, C75 | 2 | Vishay Vitramon | VJ0805G225KXYTW1BC | Volume Production | DigiKey | 720-1727-1-ND
 | 10000 pF | CAP CER 0805 10NF 16V X7R 10% | C37, C47 | 2 |  |  |  | DigiKey | 399-C0805C103K4REC7800CT-ND
 | 12 pF | CAP CER 12PF 10V X8R 0805 | C45, C55, C215, C225 | 4 |  |  |  | DigiKey | 399-C0805C120J8HAC7800CT-ND
 | Green | LED GREEN 1206 SMD | D11 | 1 |  |  |  | DigiKey | 350-597-6322-107FCT-ND
 | Green | LED GREEN CLEAR 0805 SMD | D16, D26, D36 | 3 | Bivar | SM0805UGC | Not Recommended for New Design | DigiKey | 492-1329-1-ND
 | Red | LED RED CLEAR 1206 SMD | D21 | 1 |  |  |  | DigiKey | 1080-25-21/R6C-BR2S2B/2ACT-ND
 | 1-776200-5 | Connector | J18 | 1
 | FTSH-105-01-L-DV-A | Connector | J28 | 1
 | 87527-2 | Connector | J38 | 1
 | 330 µH | FIXED IND 330UH 1.1A 600MOHM SMD | L11, L21 | 2 |  |  |  | DigiKey | SRR1280-331KLCT-ND
 | glcd128*64 |  | LCD14 | 1
 | SMI-1027-TW-5V-R | AUDIO MAGNETIC IND 4-7V SMD | LS15 | 1 | Projects Unlimited | SMI-1027-TW-5V-R | New Product | DigiKey | 668-1537-1-ND
 | PC817XNNIP1B | Phototransistor | Q12, Q22, Q32, Q42, Q52, Q62, Q72, Q82, Q92, Q102, Q112 | 11
 | MMBT4124LT1G | TRANS NPN 25V 0.2A SOT23-3 | Q15 | 1 |  |  |  | DigiKey | MMBT4124LT1GOSCT-ND
 | 470 Ohms | RES 470 OHM 1% 1/4W 0805 | R11, R21 | 2 |  |  |  | DigiKey | 13-AC0805FR-7W470RLCT-ND
 | 19.1 kOhms | RES SMD 19.1K OHM 1% 1/8W 0805 | R12, R22, R42, R52, R62, R172, R182, R192, R202 | 9 |  |  |  | DigiKey | 541-19.1KCCT-ND
 | 10 kOhms | RES 10 KOHM 1% 1/4W 0805 | R13 | 1 | Yageo | AC0805FR-7W10KL |  | DigiKey | 13-AC0805FR-7W10KLCT-ND
 | 10 kOhms | TRIMMER 10K OHM 0.5W PC PIN TOP | R14 | 1 |  |  |  | DigiKey | 3386P-103LF-ND
 | 10 kOhms | RES SMD 10K OHM 5% 1/8W 0805 | R15, R35 | 2 |  |  |  | DigiKey | YAG3758CT-ND
 | 470 Ohms | RES SMD 470 OHM 5% 1/8W 0805 | R16, R26, R36 | 3 |  |  |  | DigiKey | YAG3791CT-ND
 | 120 Ohms | RES 120 OHM 1% 1/8W 0805 | R23 | 1 |  |  |  | DigiKey | 311-120CRCT-ND
 | 510 Ohms | 3430 A2 1% 510R 100PPM 1K RL | R25 | 1 |  |  |  | DigiKey | 1712-3430A2F510RTDFCT-ND
 | 48.7 kOhms | RES SMD 48.7K OHM 1% 1/8W 0805 | R32, R212 | 2 | Vishay | CRCW080548K7FKEA | Volume Production | DigiKey | 541-48.7KCCT-ND
 | 0 Ohms | RES SMD 0 OHM JUMPER 1/8W 0805 | R45 | 1 |  |  |  | DigiKey | 13-AA0805JR-070RLCT-ND
 | 10 kOhms | RES 10K OHM 0.1% 1/5W 0805 | R46, R56, R102, R232 | 4 | TE Connectivity AMP | 9-2176375-1 |  | DigiKey | 1712-9-2176375-1CT-ND
 | 100 Ohms | RES 100 OHM 1% 1/4W 0805 | R55, R65 | 2 |  |  |  | DigiKey | 13-AC0805FR-7W100RLCT-ND
 | 750 Ohms | RES 750 OHM 0.1% 1/8W 0805 | R72, R82, R302 | 3 |  |  |  | DigiKey | RNCF0805BTE750RCT-ND
 | 0 Ohms | RES 0 OHM JUMPER 0805 | R75, R85, R95, R105, R115, R125 | 6 |  |  |  | DigiKey | 18-WJC0805LJUMPFNRCT-ND
 | 1.2 kOhms | RES SMD 1.2K OHM 0.1% 1/10W 0805 | R92, R222 | 2 |  |  |  | DigiKey | A103167CT-ND
 | 10 kOhms | 3430 A2 1% 10K 100PPM 1K RL | R112, R122, R132, R142, R152, R162, R252, R262, R272, R282, R292 | 11 |  |  |  | DigiKey | 1712-3430A2F10KTDFCT-ND
 | B3WN-6002 | Switch | S19, S29, S39 | 3
 | LM2575-3.3BU | No Description Available | U11 | 1
 | MCP2551T-ISN | No Description Available | U13 | 1
 | STM32F407VGT6 | No Description Available | U15 | 1
 | ADC122S101CIMMNOPB | No Description Available | U16, U26, U36 | 3
 | MAX31855KASA+T | No Description Available | U17, U27 | 2
 | LM2575-5.0BU | No Description Available | U21 | 1
 | 1N5819HW-7-F | No Description Available | U31, U41 | 2
 | 32.768 kHz | CRYSTAL 32.7680KHZ 12.5PF SMD | Y15 | 1 | Micro Crystal | 202752-MC01 |  | DigiKey | 2195-CM8V-T1A-32.768KHZ-12.5PF-20PPM-TA-QACT-ND
 | 8MHz | CRYSTAL 8.0000MHZ 8PF SMD | Y25 | 1 |  |  |  | DigiKey | 644-1018-1-ND
