MiroslavMitrovic/DashDataDisplay_STM32/Design/ArchitectureDiagrams/DashDataDisplay_SW_ComponentLayoutDiagram.png

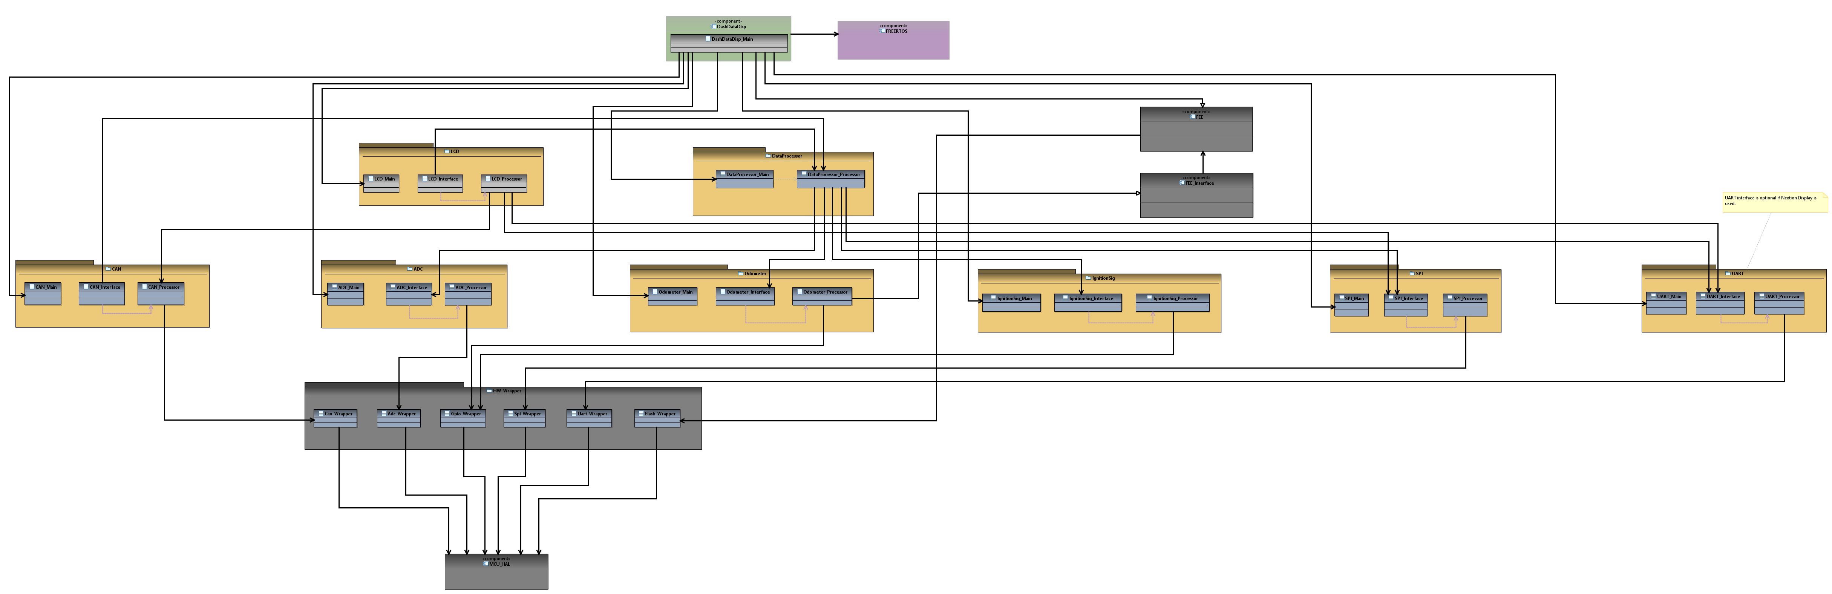
Design/ArchitectureDiagrams/DashDataDisplay_SW_ComponentLayoutDiagram.png
