MiroslavMitrovic/DashDataDisplay_STM32/Hardware/DashDataDisplay/01_Parts/LIB_1-776200-5-Connector/1-776200-5/3D/1-776200-5.stp

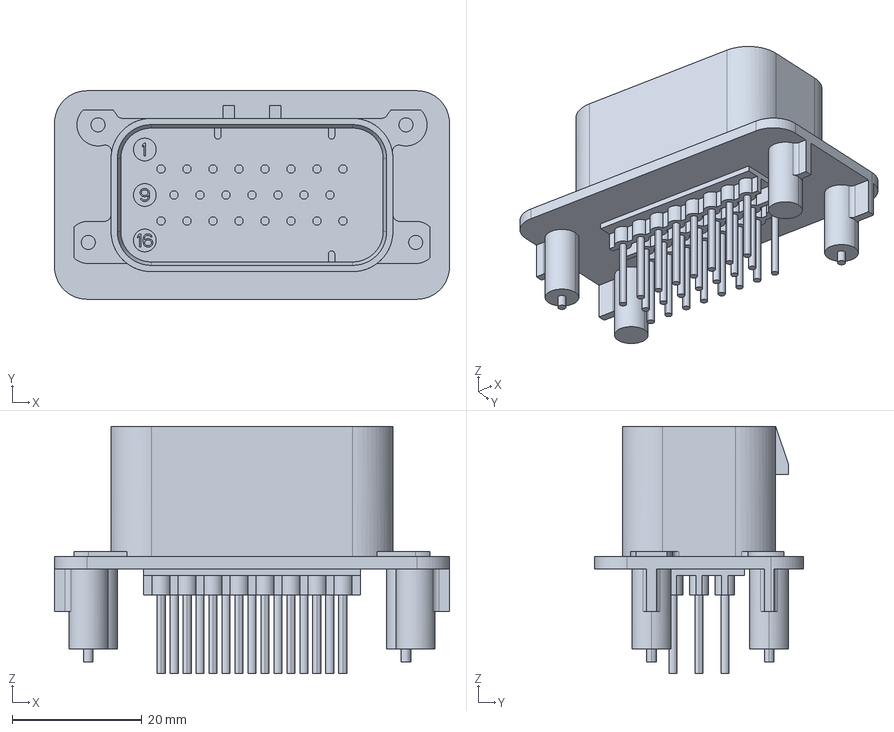
[picture p31: CAD file, 2024-06-19]
Hardware/DashDataDisplay/01_Parts/LIB_1-776200-5-Connector/1-776200-5/3D/1-776200-5.stp
60.8 x 32.1 x 38.1 mm
