MiroslavMitrovic/DashDataDisplay_STM32/Hardware/DashDataDisplay/01_Parts/LIB_B3WN-6002/B3WN-6002/3D/B3WN-6002.stp

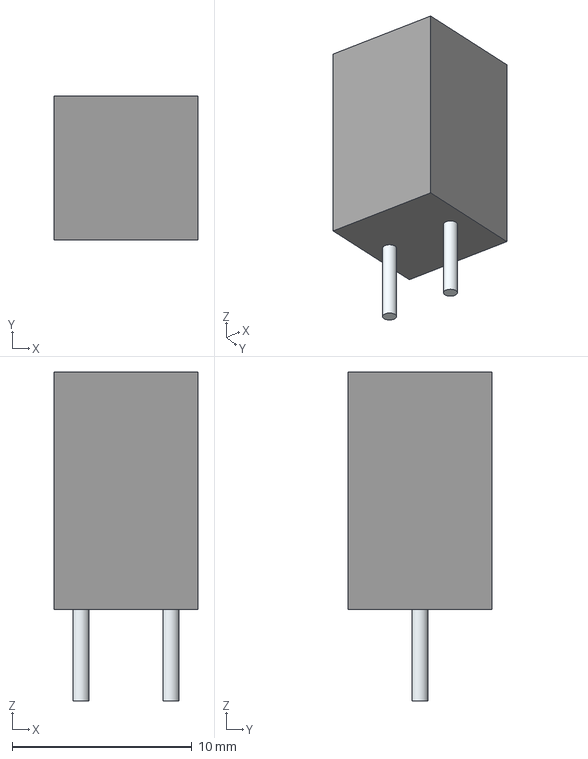
[picture p32: CAD file, 2024-06-19]
Hardware/DashDataDisplay/01_Parts/LIB_B3WN-6002/B3WN-6002/3D/B3WN-6002.stp
8.00 x 8.00 x 18.3 mm
Leads
