MiroslavMitrovic/DashDataDisplay_STM32/Hardware/DashDataDisplay/01_Parts/LIB_C0805C334K4RACTM/C0805C334K4RACTM/3D/C0805C334K4RACTM.stp

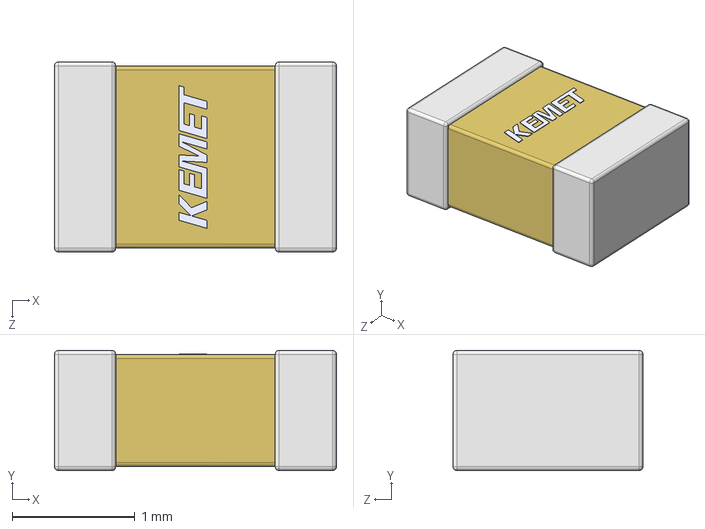
[picture p33: CAD file, 2024-06-19]
Hardware/DashDataDisplay/01_Parts/LIB_C0805C334K4RACTM/C0805C334K4RACTM/3D/C0805C334K4RACTM.stp
2.30 x 0.98 x 1.55 mm
