MiroslavMitrovic/DashDataDisplay_STM32/Hardware/DashDataDisplay/01_Parts/LIB_PC817XNNIP1B/PC817XNNIP1B/3D/PC817XNNIP1B.stp

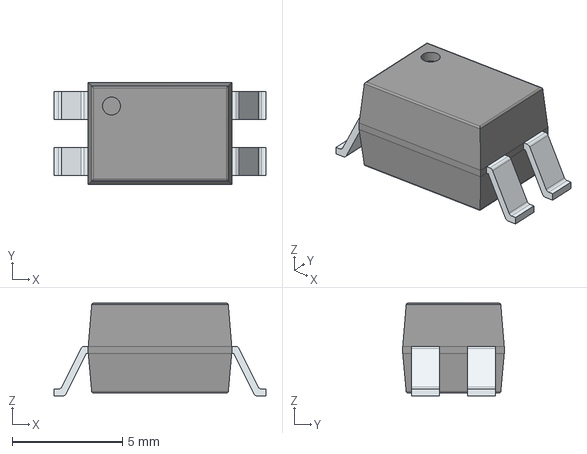
[picture p34: CAD file, 2024-06-19]
Hardware/DashDataDisplay/01_Parts/LIB_PC817XNNIP1B/PC817XNNIP1B/3D/PC817XNNIP1B.stp
9.60 x 4.60 x 4.20 mm
PinsArrayLR
