MiroslavMitrovic/DashDataDisplay_STM32/Hardware/DashDataDisplay/01_Parts/ul_1N5819HW-7-F/AltiumDesigner/1N5819HW-7-F_DIO.step

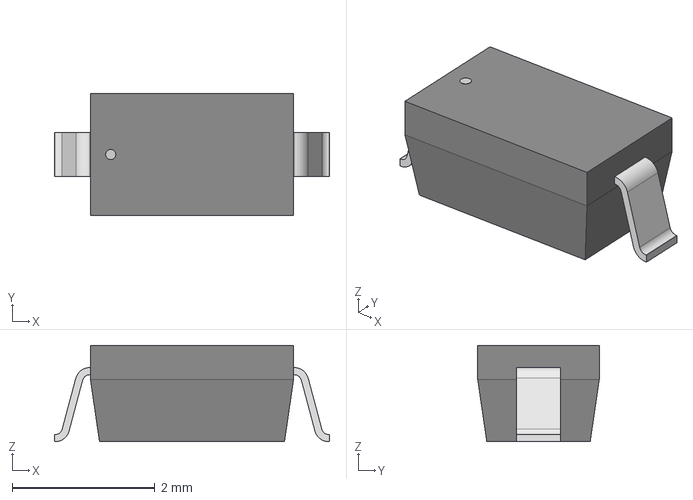
[picture p35: CAD file, 2024-06-19]
Hardware/DashDataDisplay/01_Parts/ul_1N5819HW-7-F/AltiumDesigner/1N5819HW-7-F_DIO.step
3.85 x 1.70 x 1.35 mm
