MiroslavMitrovic/DashDataDisplay_STM32/Hardware/DashDataDisplay/01_Parts/ul_ADC122S101CIMM-NOPB/AltiumDesigner/MUA08A.step

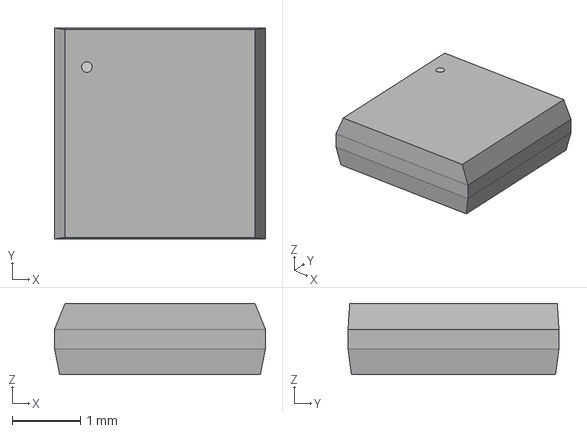
[picture p36: CAD file, 2024-06-19]
Hardware/DashDataDisplay/01_Parts/ul_ADC122S101CIMM-NOPB/AltiumDesigner/MUA08A.step
3.10 x 3.10 x 1.04 mm
