MiroslavMitrovic/DashDataDisplay_STM32/Hardware/DashDataDisplay/01_Parts/ul_B82477P4334M000/AltiumDesigner/IND_EPCOS_B82477P4_EPC.step

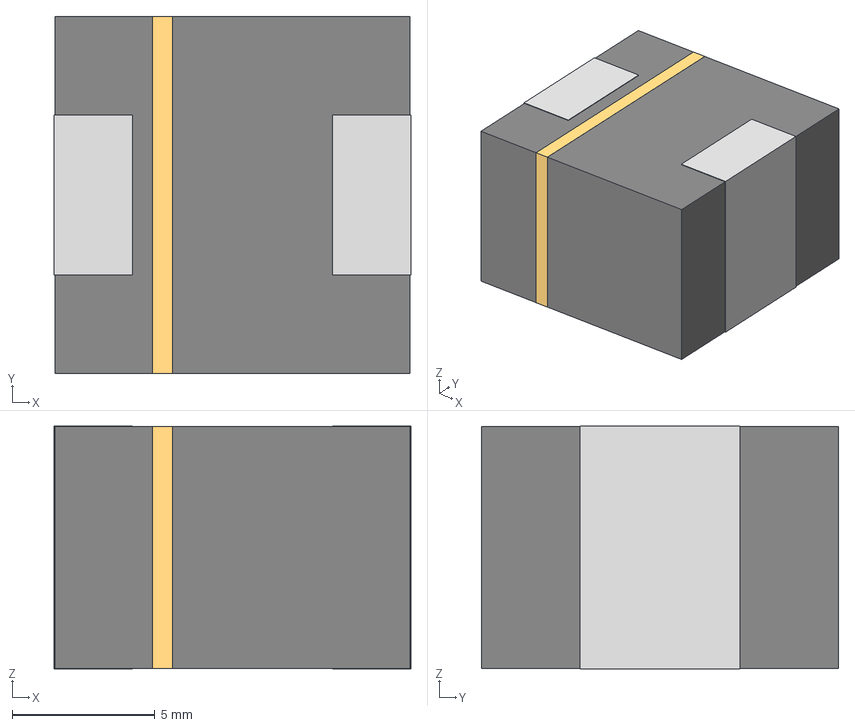
[picture p37: CAD file, 2024-06-19]
Hardware/DashDataDisplay/01_Parts/ul_B82477P4334M000/AltiumDesigner/IND_EPCOS_B82477P4_EPC.step
12.5 x 12.5 x 8.51 mm
