MiroslavMitrovic/DashDataDisplay_STM32/Hardware/DashDataDisplay/01_Parts/ul_EEUFC0J101/AltiumDesigner/CAP_5X11_PAN.step

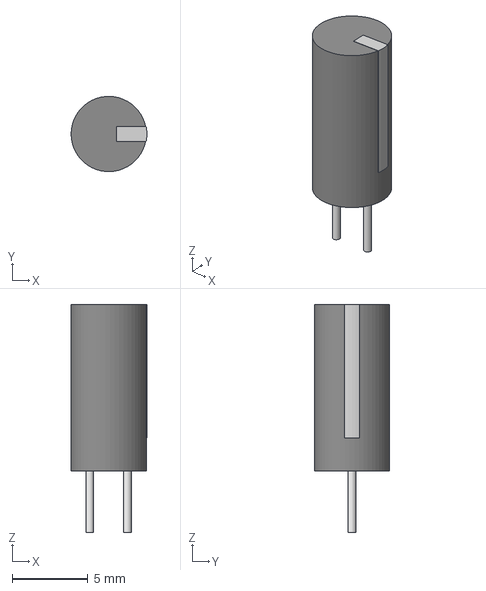
[picture p38: CAD file, 2024-06-19]
Hardware/DashDataDisplay/01_Parts/ul_EEUFC0J101/AltiumDesigner/CAP_5X11_PAN.step
5.01 x 4.98 x 15.1 mm
