MiroslavMitrovic/DashDataDisplay_STM32/Hardware/DashDataDisplay/01_Parts/ul_LM2575-3-3BU/AltiumDesigner/TO-263-5_MCL.step

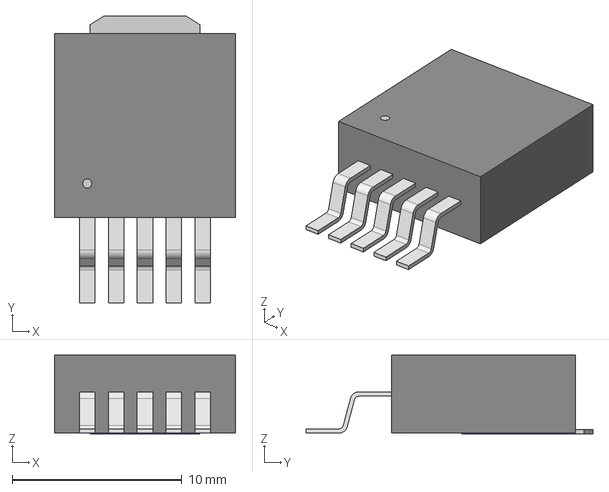
[picture p39: CAD file, 2024-06-19]
Hardware/DashDataDisplay/01_Parts/ul_LM2575-3-3BU/AltiumDesigner/TO-263-5_MCL.step
10.7 x 16.9 x 4.65 mm
