MiroslavMitrovic/DashDataDisplay_STM32/Hardware/DashDataDisplay/01_Parts/ul_MAX31855KASA-T/AltiumDesigner/21-0041B_8_MXM.step

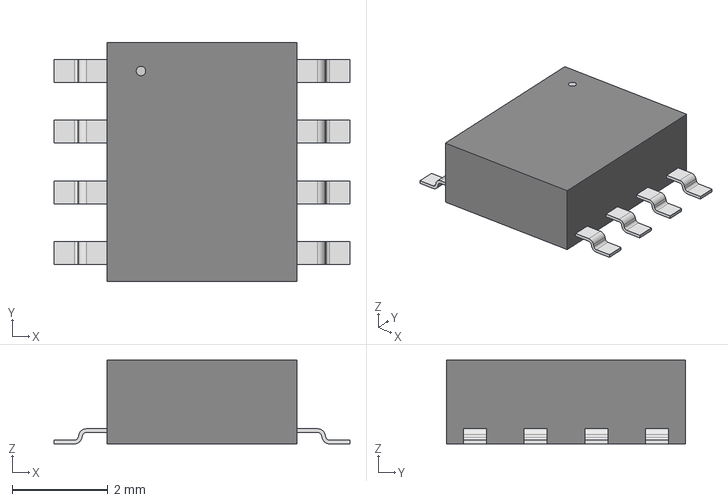
[picture p40: CAD file, 2024-06-19]
Hardware/DashDataDisplay/01_Parts/ul_MAX31855KASA-T/AltiumDesigner/21-0041B_8_MXM.step
6.20 x 5.00 x 1.75 mm
