MiroslavMitrovic/DashDataDisplay_STM32/Hardware/DashDataDisplay/01_Parts/ul_MCP2551T-I-SN/AltiumDesigner/SOIC8-N_MC_MCH.step

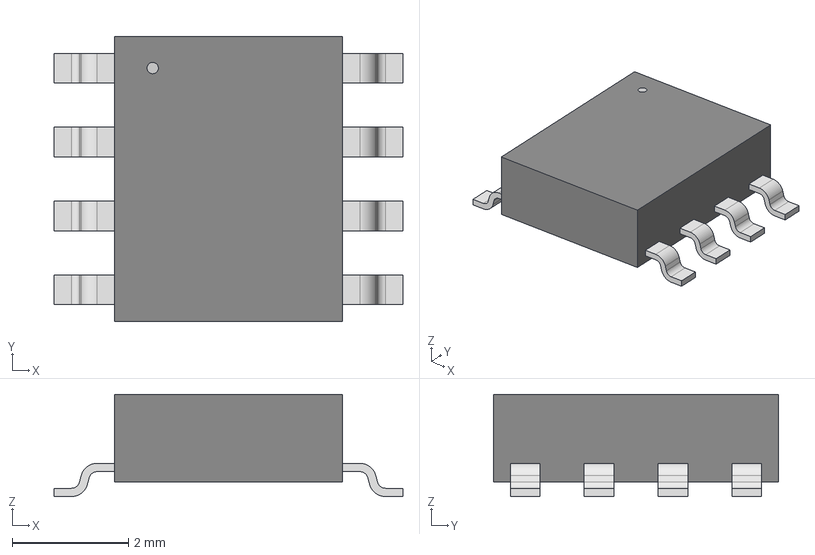
[picture p41: CAD file, 2024-06-19]
Hardware/DashDataDisplay/01_Parts/ul_MCP2551T-I-SN/AltiumDesigner/SOIC8-N_MC_MCH.step
5.99 x 4.90 x 1.75 mm
