MiroslavMitrovic/DashDataDisplay_STM32/Hardware/DashDataDisplay/01_Parts/ul_STM32F407VGT6/AltiumDesigner/LQFP100-14x14mm.step

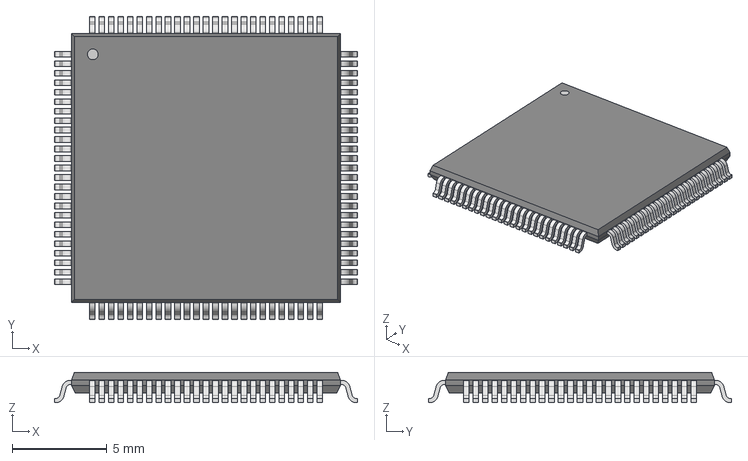
[picture p42: CAD file, 2024-06-19]
Hardware/DashDataDisplay/01_Parts/ul_STM32F407VGT6/AltiumDesigner/LQFP100-14x14mm.step
16.0 x 16.0 x 1.60 mm
