MiroslavMitrovic/DashDataDisplay_STM32/Hardware/DashDataDisplay/01_Parts/LIB_87527-2/87527-2/3D/87527-2.stp

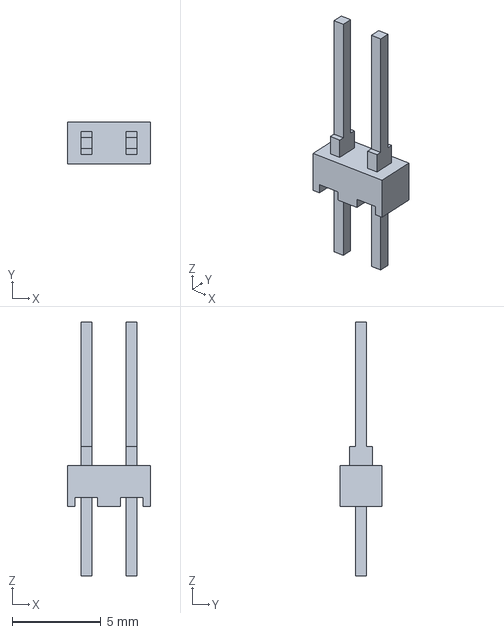
[picture p43: CAD file, 2024-06-19]
Hardware/DashDataDisplay/01_Parts/LIB_87527-2/87527-2/3D/87527-2.stp
4.67 x 2.34 x 14.3 mm
