MiroslavMitrovic/DashDataDisplay_STM32/(list of files, cad)

Other CAD files:
Hardware/DashDataDisplay/01_Parts/ul_LM2575-5-0BU/AltiumDesigner/TO-263-5_MCL.step
Hardware/DashDataDisplay/01_Parts/LIB_1-776200-5-Connector/1-776200-5/Allegro/17762005.psm
Hardware/DashDataDisplay/01_Parts/LIB_1-776200-5-Connector/1-776200-5/DEHDL/1_776200_5/chips/chips.prt
Hardware/DashDataDisplay/01_Parts/LIB_87527-2/87527-2/Allegro/hdrv2w66p0x254_1x2_467x244x1044p.psm
Hardware/DashDataDisplay/01_Parts/LIB_87527-2/87527-2/DEHDL/87527_2/chips/chips.prt
Hardware/DashDataDisplay/01_Parts/LIB_B3WN-6002/B3WN-6002/Allegro/b3wn6002.psm
Hardware/DashDataDisplay/01_Parts/LIB_B3WN-6002/B3WN-6002/DEHDL/b3wn_6002/chips/chips.prt
Hardware/DashDataDisplay/01_Parts/LIB_C0805C334K4RACTM/C0805C334K4RACTM/Allegro/c0805.psm
Hardware/DashDataDisplay/01_Parts/LIB_C0805C334K4RACTM/C0805C334K4RACTM/DEHDL/c0805c334k4ractm/chips/chips.prt
Hardware/DashDataDisplay/01_Parts/LIB_FTSH-105-01-L-DV-A/FTSH-105-01-L-DV-A/Allegro/ftsh-105-xx-yyy-dv-a.psm
Hardware/DashDataDisplay/01_Parts/LIB_FTSH-105-01-L-DV-A/FTSH-105-01-L-DV-A/DEHDL/ftsh_105_01_l_dv_a/chips/chips.prt
Hardware/DashDataDisplay/01_Parts/LIB_PC817XNNIP1B/PC817XNNIP1B/Allegro/sop254p960x420-4n.psm
Hardware/DashDataDisplay/01_Parts/LIB_PC817XNNIP1B/PC817XNNIP1B/DEHDL/pc817xnnip1b/chips/chips.prt
