MiroslavMitrovic/DashDataDisplay_STM32/Design/Requirements/SenzorPritiskaKalibracija.xlsx

Sheet: Sheet1
Pressure[bar] | Ressistance[Ohm]
0 | 21.1
1 | 27.5
1.5 | 37.5
2 | 47.5
2.5 | 60.5
3 | 70
3.5 | 83.5
4 | 90
4.5 | 100
5 | 106.5
5.5 | 123
k | n
19.3474 | 12.5737
 |  | 12.5737
 |  | 31.9211
 |  | 41.5948
 |  | 51.2685
 |  | 60.9422
 |  | 70.6159
 |  | 80.2896
 |  | 89.9633
 |  | 99.637
 |  | 109.3107
 |  | 118.9844

Sheet: Sheet2
21.1 | 23.4
27.5 | 30
37.5 | 40
47.5 | 53
60.5 | 62.5
70 | 76
83.5 | 85.5
90 | 95.5
100 | 105
106.5 | 112
123 | 125
