MiroslavMitrovic/DashDataDisplay_STM32/Design/ArchitectureDiagrams/PressureSensorCalibrationFitting.png

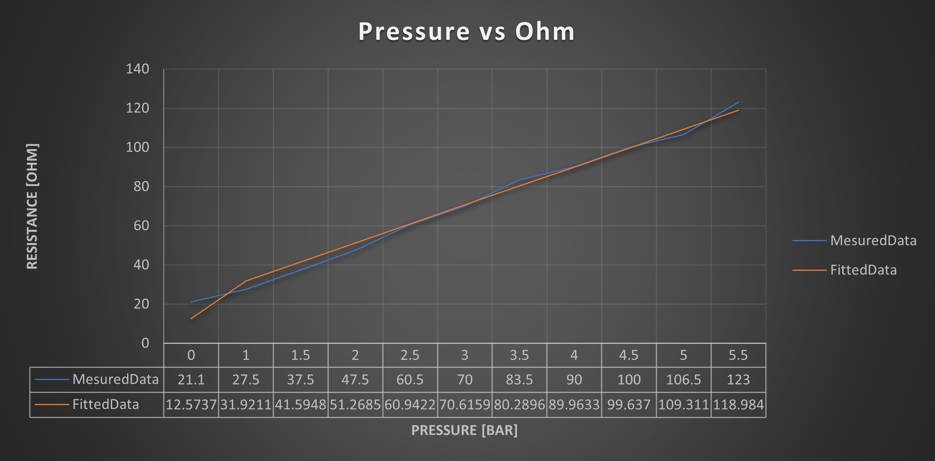
Design/ArchitectureDiagrams/PressureSensorCalibrationFitting.png
