MiroslavMitrovic/DashDataDisplay_STM32/Hardware/DashDataDisplay/SchematicsPdf.pdf

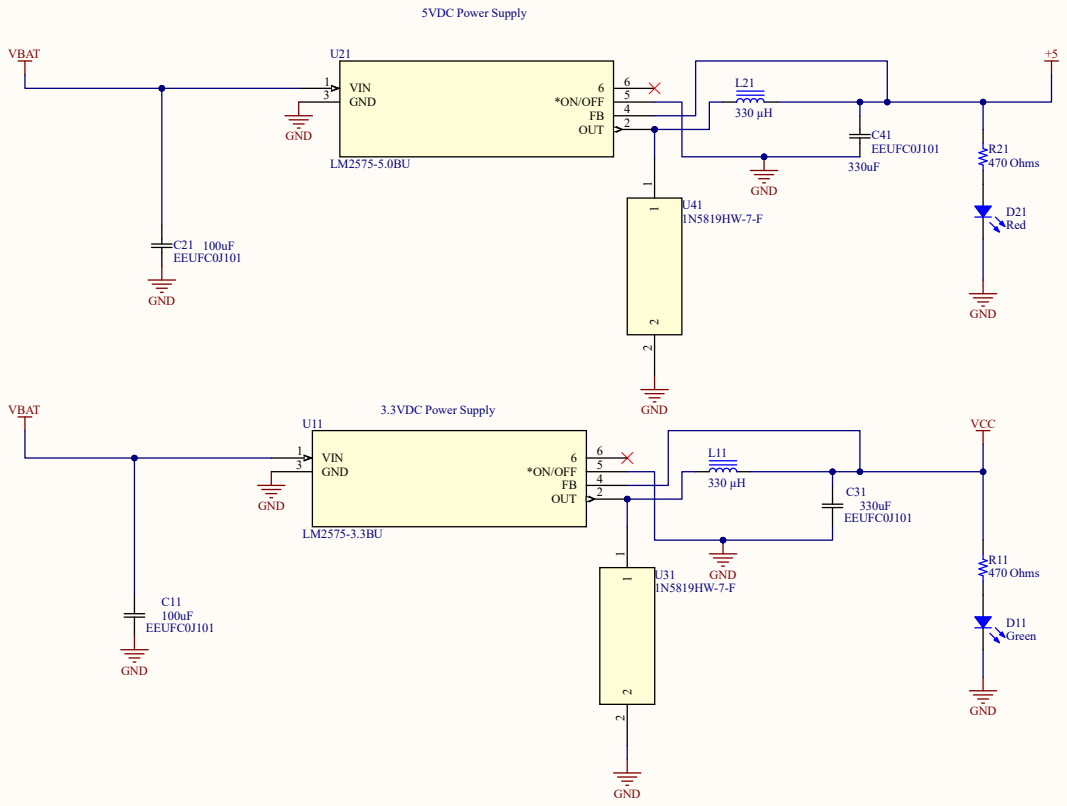
[picture p45: page 1]

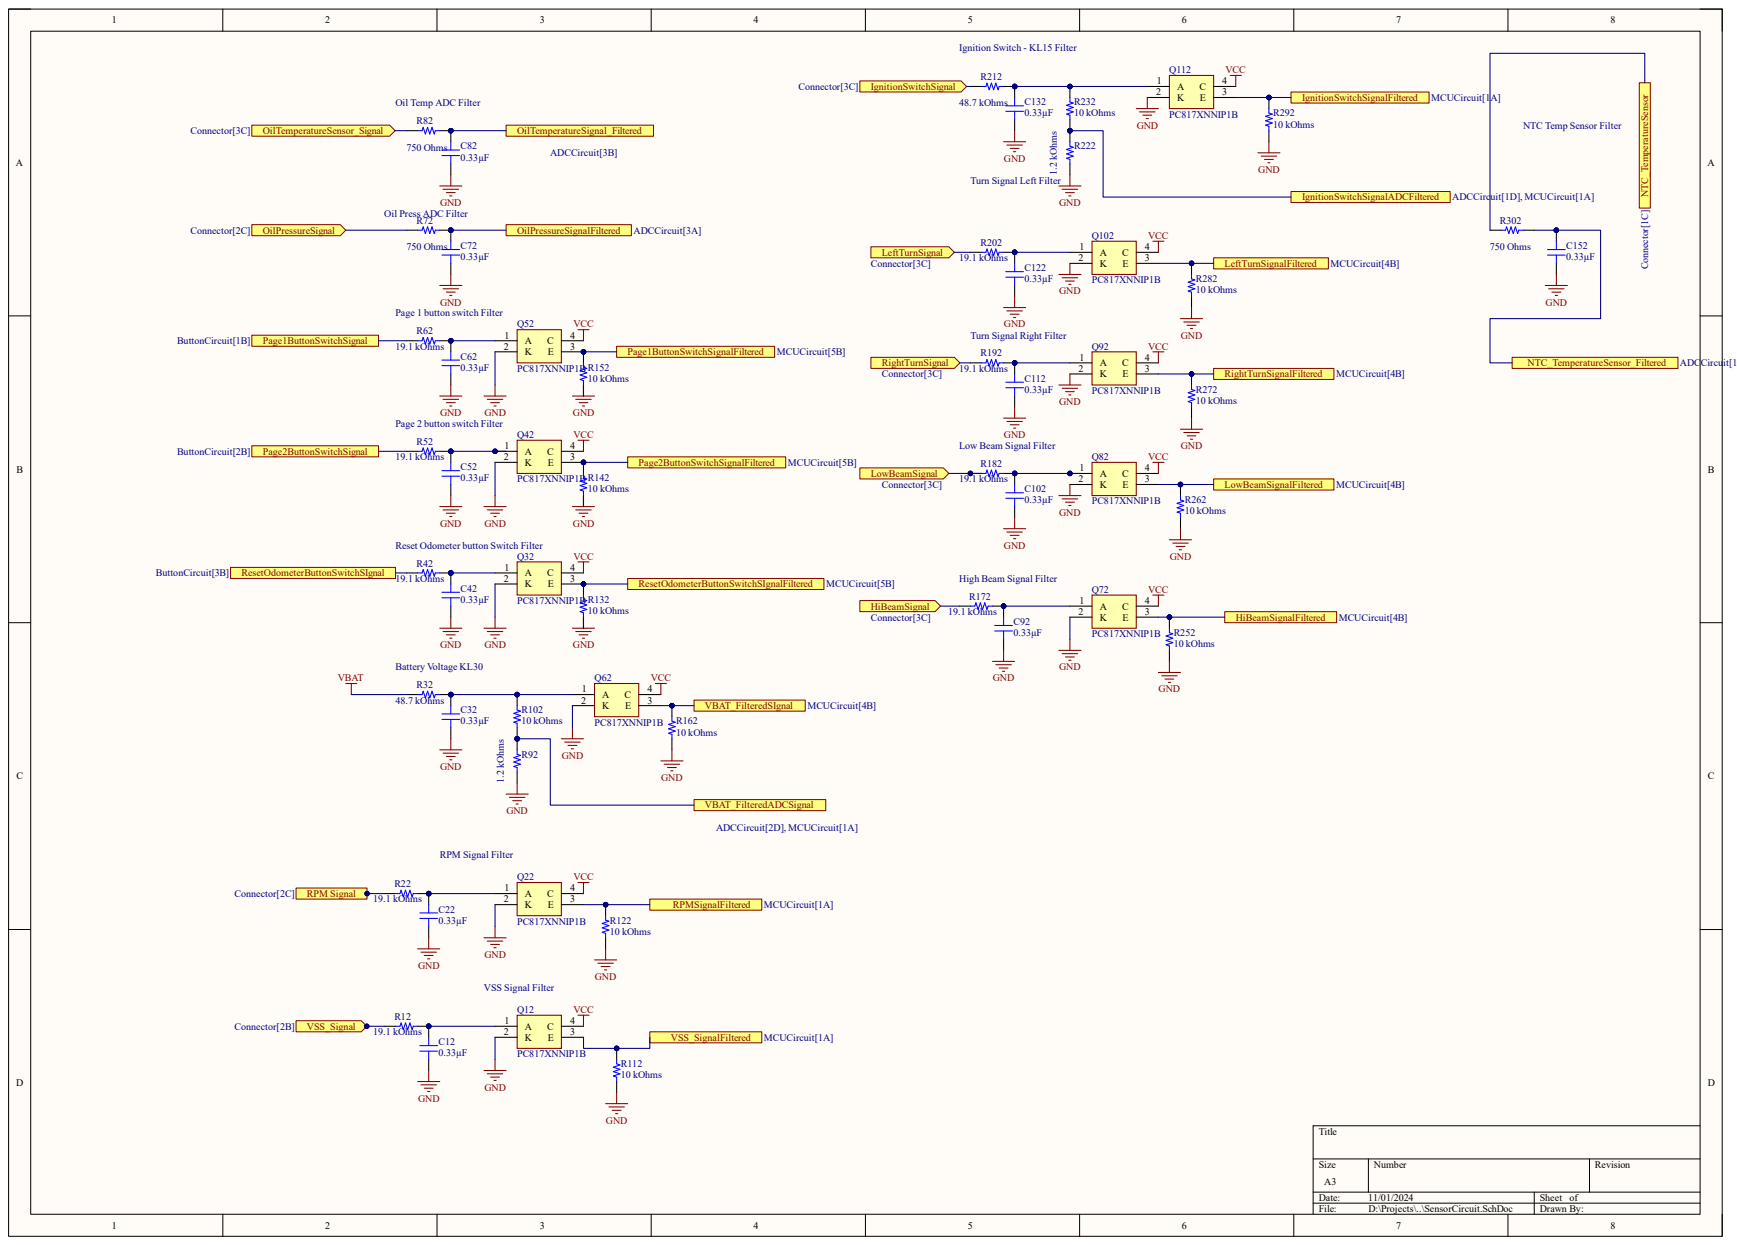
[picture p46: page 2]

Oil Temp ADC Filter

NTC Temp Sensor Filter

Turn Signal Left Filter

Oil Press ADC Filter

Reset Odometer button Switch Filter
19.1 kOhms

A A

U13

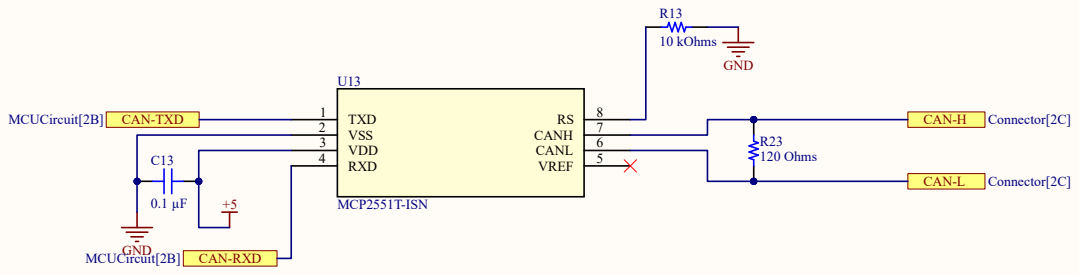
[picture p47: page 3]
Title; Size; Number; Revision; File:; D:\Projects\..\CanTrcvCircuit.SchDoc; Drawn By:; TXD 1 VSS 2 VDD 3; RXD 4; VREF; CANL; CANH; MCP2551T-ISN; 120 Ohms; 10 kOhms; GND; CAN-H; Connector[2C]; CAN-L

MCUCircuit[2B] CAN-TXD

GND
MCUCircuit[2B] CAN-RXD

A A

SPI LCD | +5 VCC 5VDC MCUCircuit[2B] MOSI_LCD

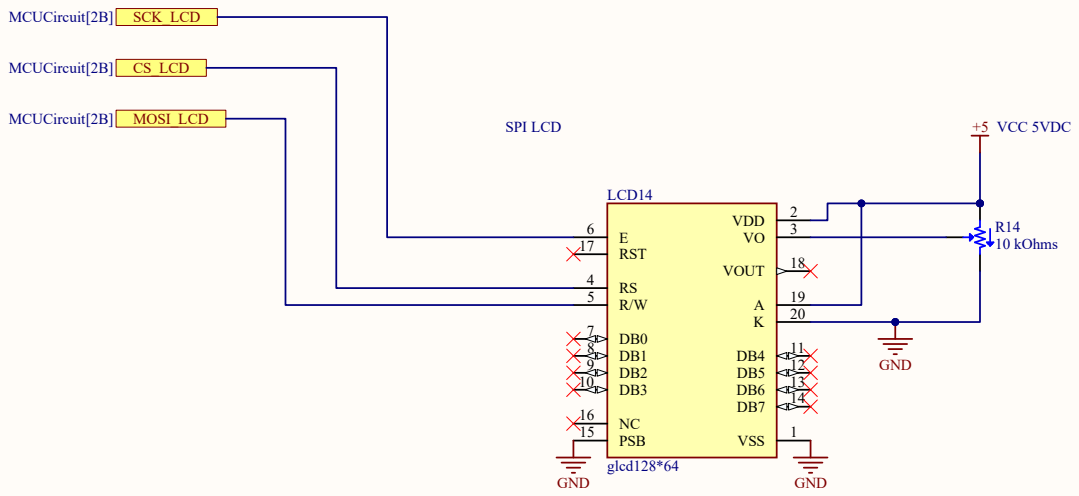
[picture p48: page 4]
Title; Size; Number; Revision; File:; D:\Projects\..\LCDCircuit.SchDoc; Drawn By:; 6 RST 17; VDD; VOUT; VSS; NC 16 PSB 15; LCD14; glcd128*64; GND; R14 10 kOhms; MCUCircuit[2B] CS_LCD; MCUCircuit[2B] SCK_LCD

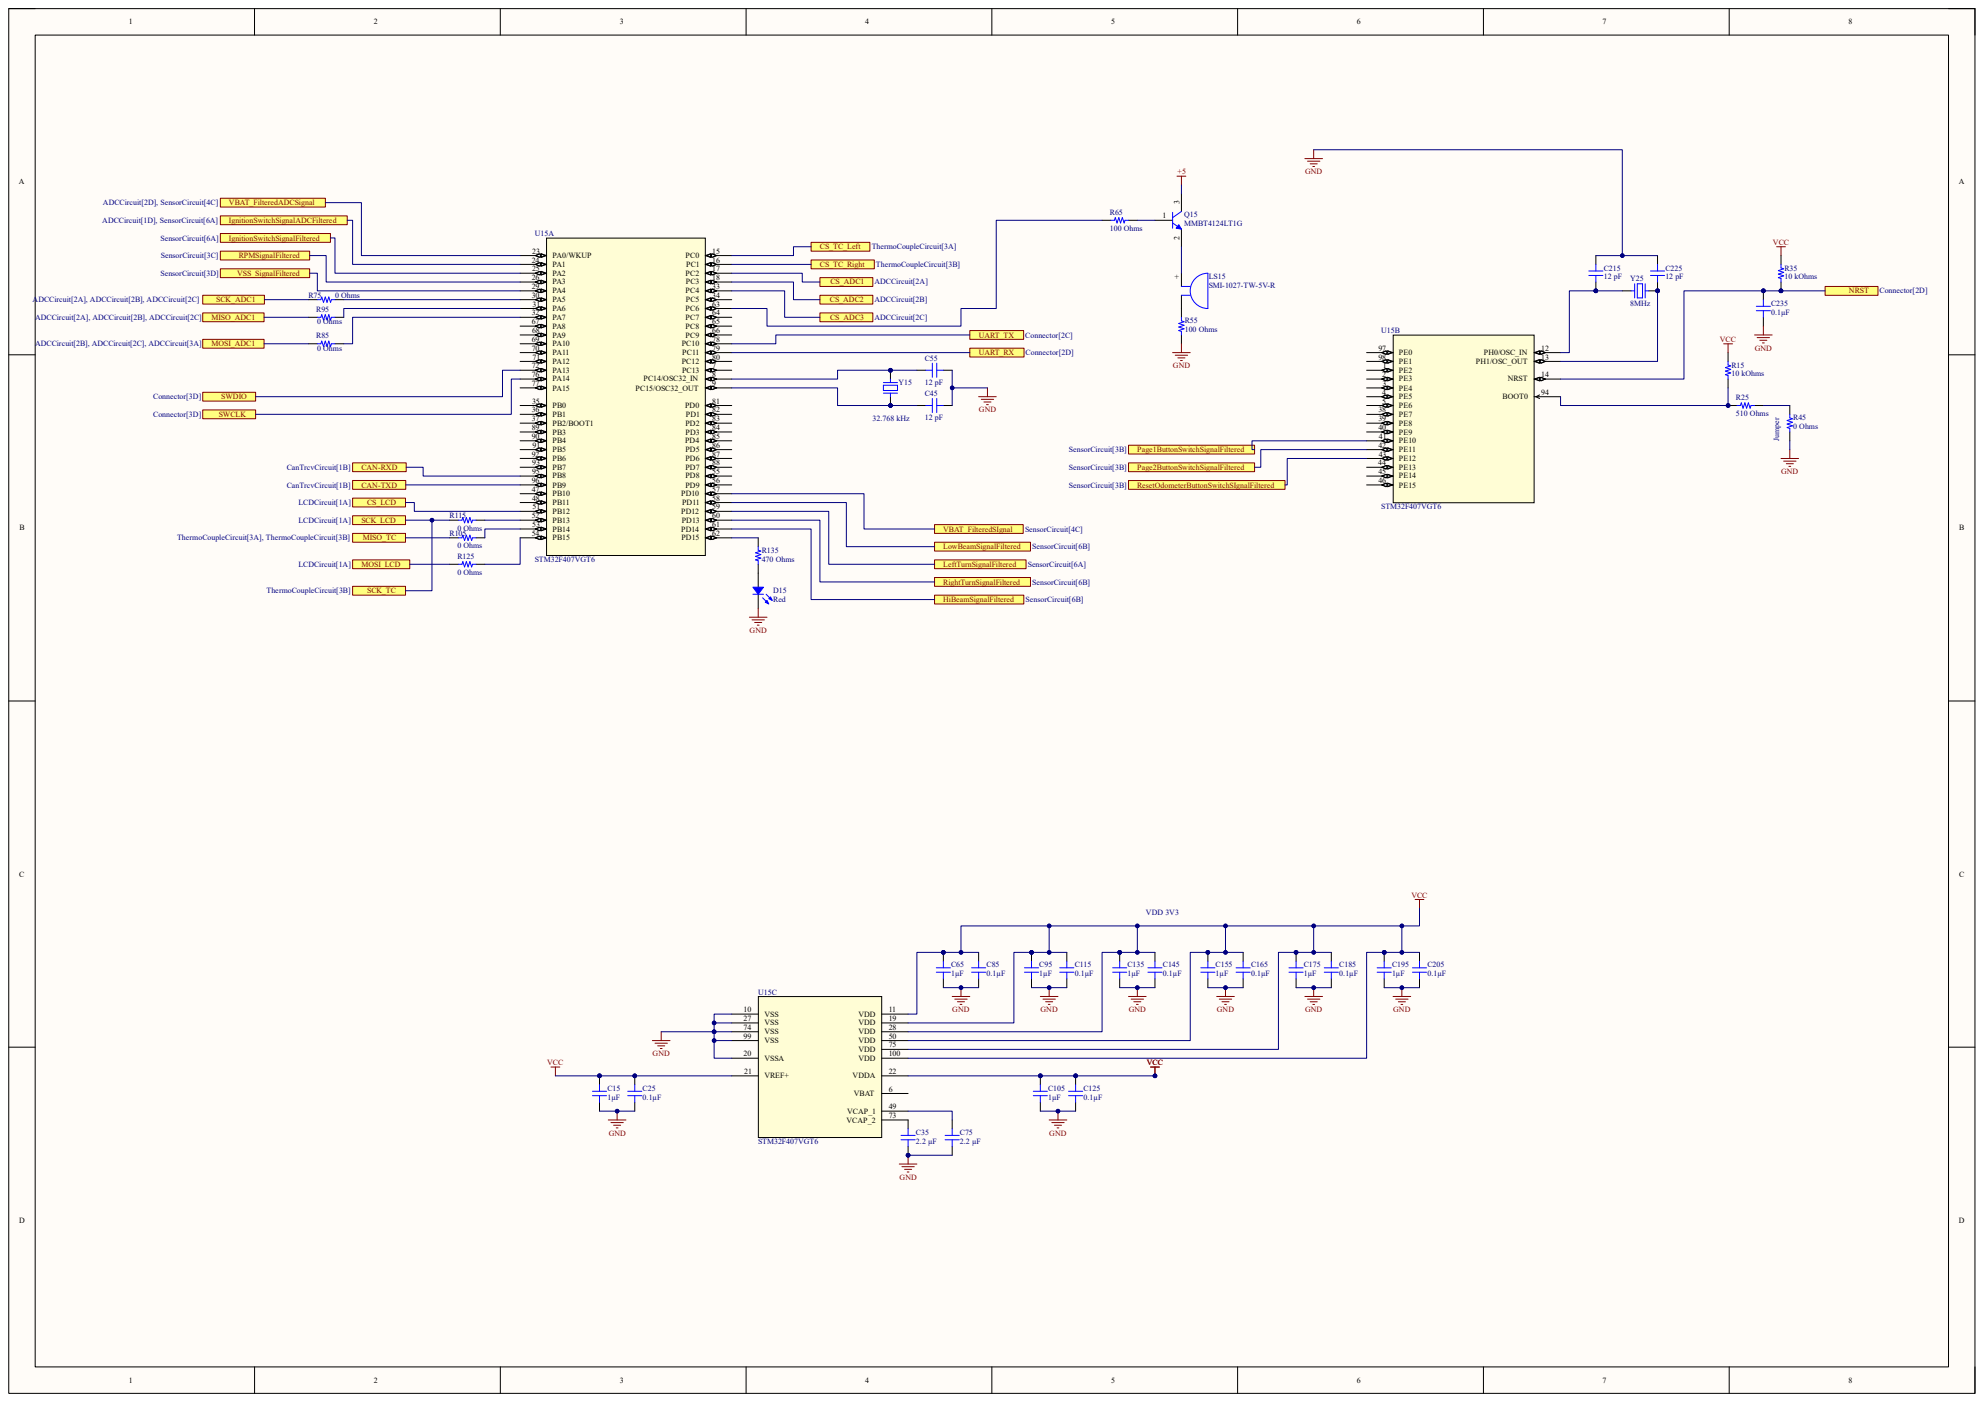
[picture p49: page 5]

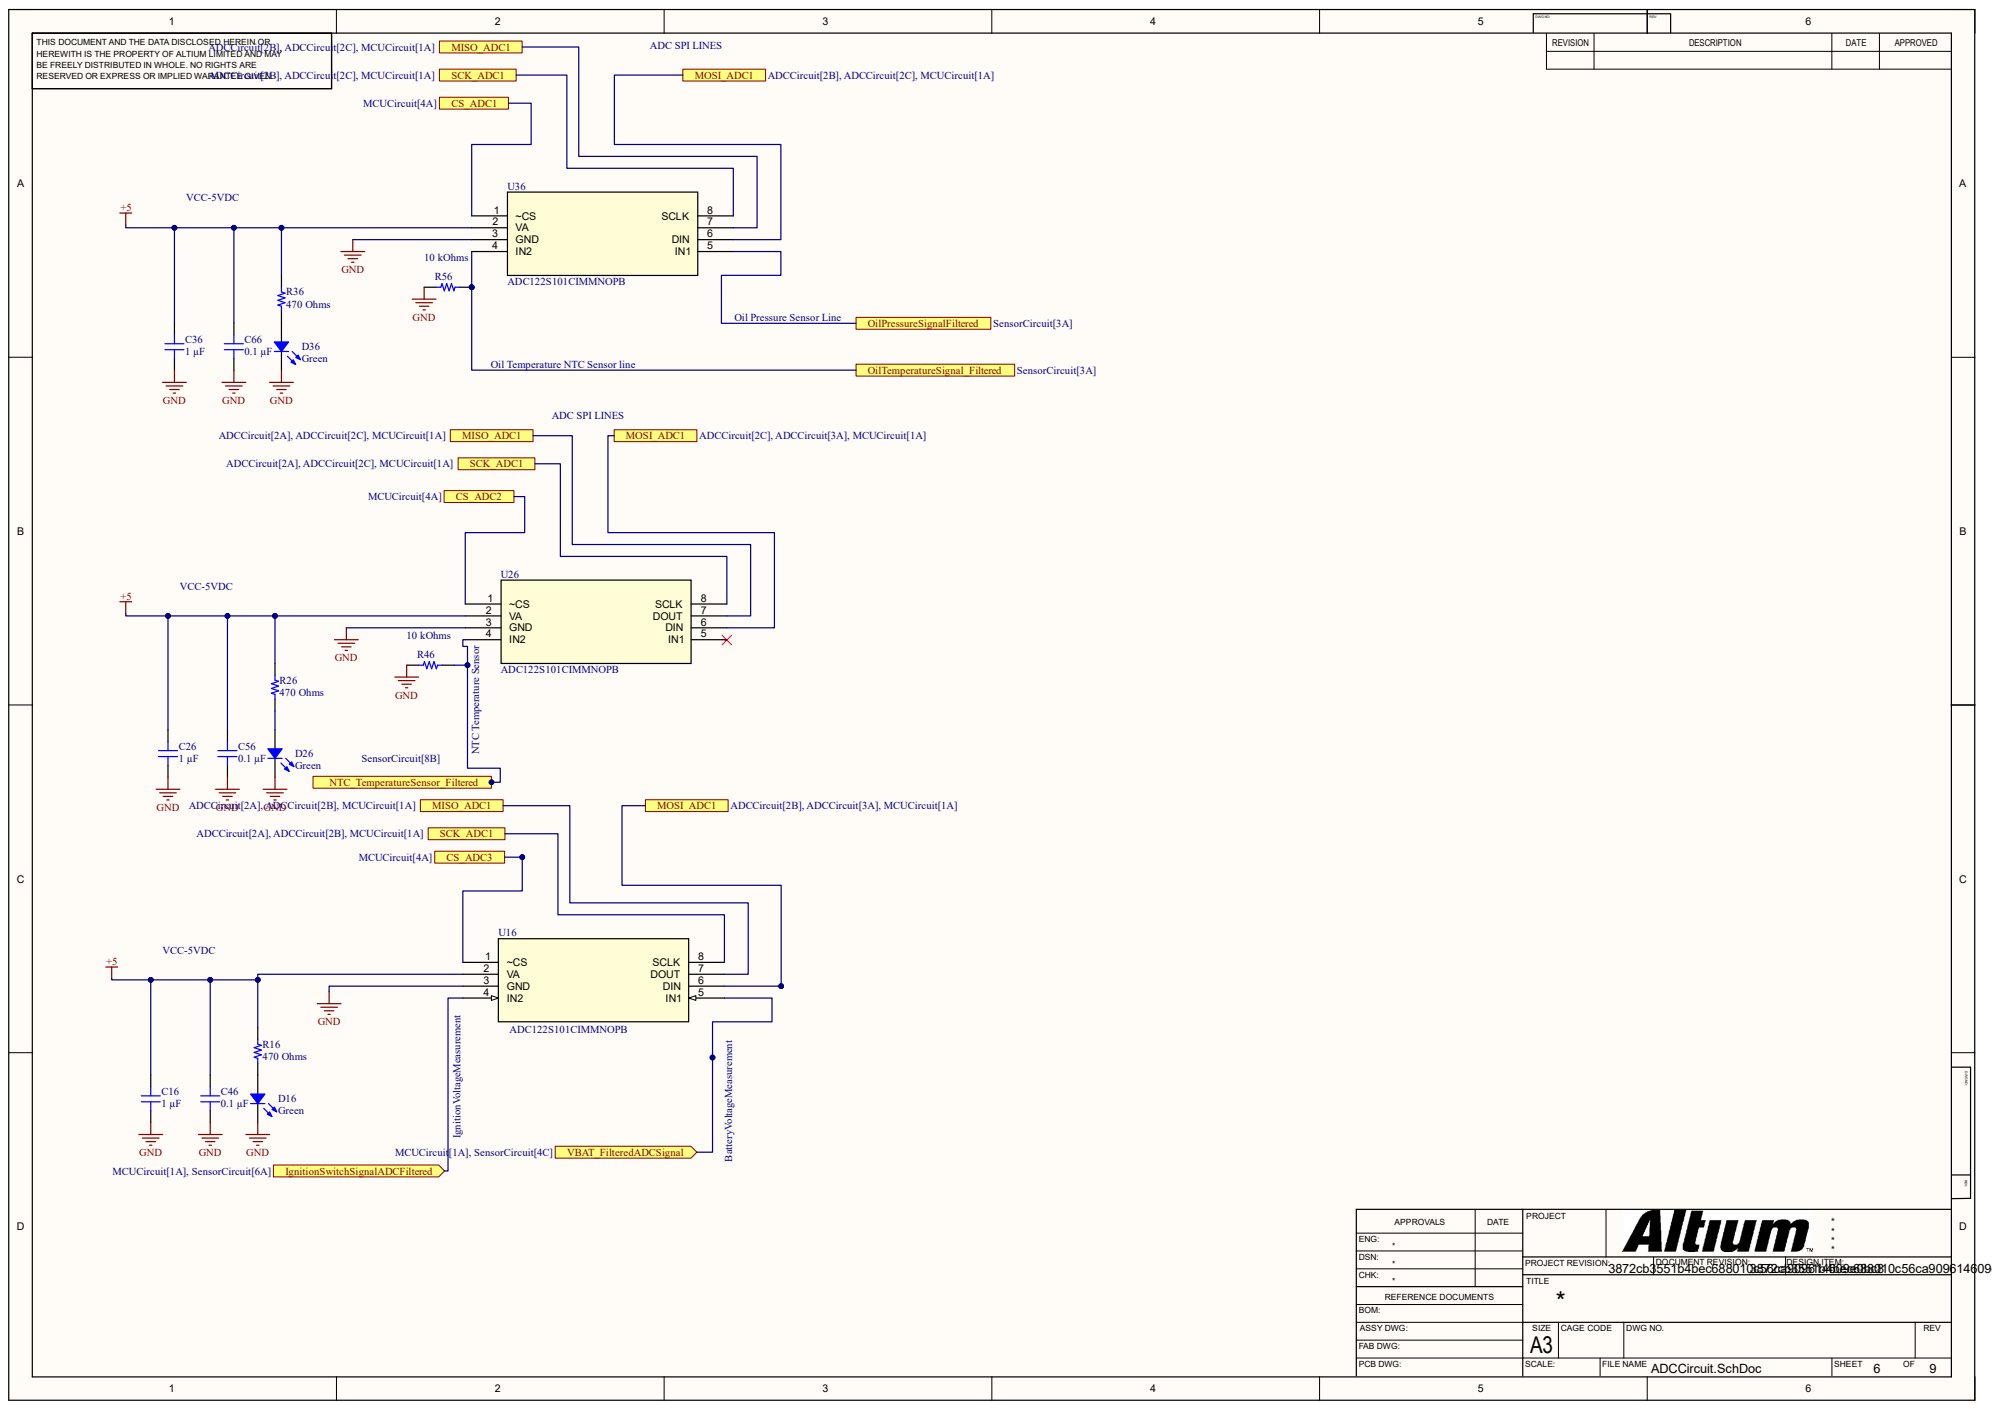
[picture p50: page 6]

DWG NO: | REV:

THIS DOCUMENT AND THE DATA DISCLOSED HEREIN OR HEREWITH IS THE PROPERTY OF ALTIUM LIMITED AND MAY BE FREELY DISTRIBUTED IN WHOLE. NO RIGHTS ARE RESERVED OR EXPRESS OR IMPLIED WARANTEE GIVEN. | | REVISION | DESCRIPTION | DATE | APPROVED

Oil Pressure Sensor Line

Oil Temperature NTC Sensor line

APPROVALS | DATE | PROJECT | * *

ENG: *
DSN: *
CHK: *

A A

## GND 1

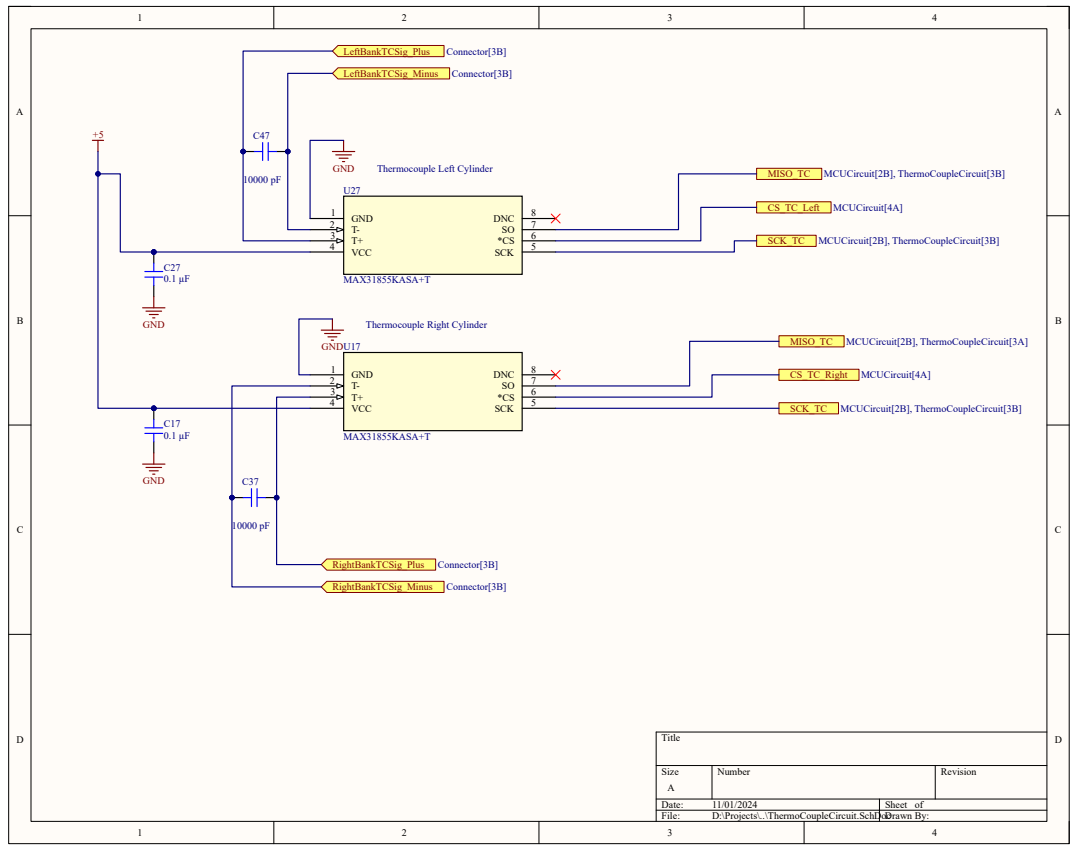
[picture p51: page 7]
Title; Size; Number; Revision; File:; D:\Projects\..\ThermoCoupleCircuit.SchDocDrawn By:; T- 2 T+ 3 VCC 4; SCK; DNC; MAX31855KASA+T; GND 1 T- 2 T+ 3; VCC 4; GND; LeftBankTCSig_Plus; Connector[3B]; LeftBankTCSig_Minus; RightBankTCSig_Plus; RightBankTCSig_Minus; MISO_TC; MCUCircuit[2B], ThermoCoupleCircuit[3B]; CS_TC_Left; MCUCircuit[4A]; SCK_TC; MCUCircuit[2B], ThermoCoupleCircuit[3A]; CS_TC_Right

Thermocouple Left Cylinder

Thermocouple Right Cylinder

B B

A A

## ThermoCoupleCircuit[2A]

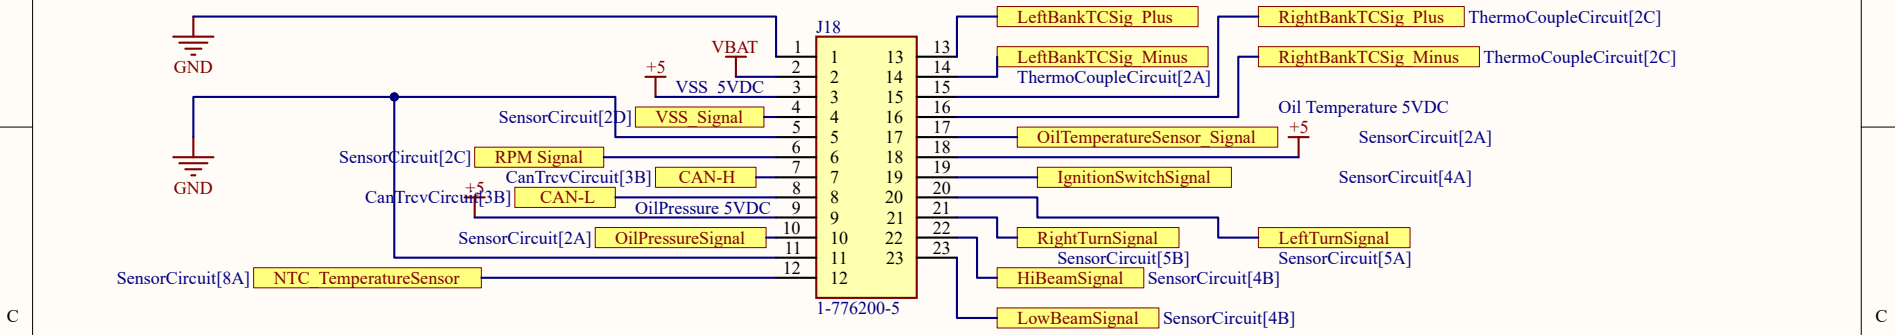
[picture p52: figure]
GND; VBAT; VSS_5VDC; SensorCircuit[2D] VSS_Signal; SensorCircuit[2C] RPM Signal; SensorCircuit[2A] OilPressureSignal; OilPressure 5VDC; LeftBankTCSig_Plus; LeftBankTCSig_Minus ThermoCoupleCircuit[2A]; IgnitionSwitchSignal; SensorCircuit[4A]; LeftTurnSignal SensorCircuit[5A]; RightTurnSignal SensorCircuit[5B]; HiBeamSignal; SensorCircuit[4B]; LowBeamSignal; CanTrcvCircuit[3B]; CAN-H; CAN-L; SensorCircuit[8A] NTC_TemperatureSensor; Oil Temperature 5VDC

RightBankTCSig_Plus | ThermoCoupleCircuit[2C]
RightBankTCSig_Minus | ThermoCoupleCircuit[2C]
OilTemperatureSensor_Signal | SensorCircuit[2A]
UART_TX | MCUCircuit[4A]
UART_RX | MCUCircuit[4A]

## UART Connector

## VCC

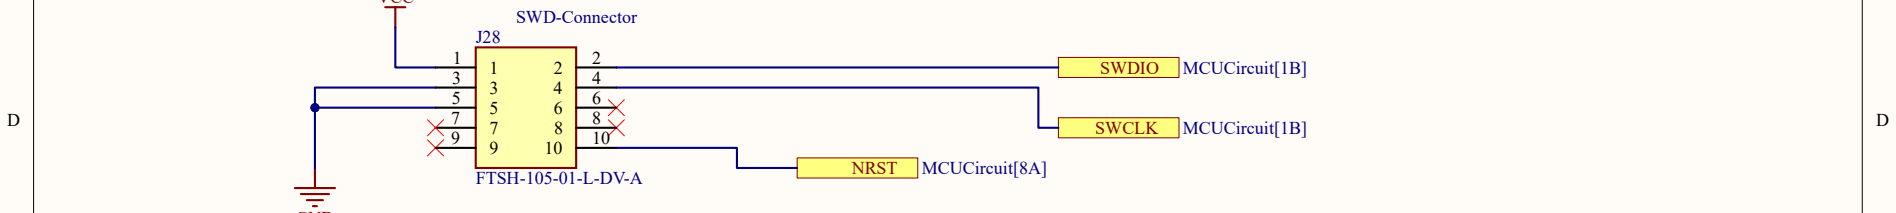
[picture p53: figure]
SWDIO MCUCircuit[1B]; SWCLK; MCUCircuit[1B]; NRST; MCUCircuit[8A]; FTSH-105-01-L-DV-A; SWD-Connector

## GND

1

1

2

2

J38

87527-2

D D

C C

B B

A A

## Title

Size | Number | Revision
File: | D:\Projects\..\ButtonCircuit.SchDoc | Drawn By:

## COM 1

NO 2

S19

## B3WN-6002

## COM 1

NO 2

S29

## B3WN-6002

## COM 1

NO 2

S39

## B3WN-6002

Page1 Button Switch | Page 2 Button Switch | Odometer Reset Button Switch
VCC | VCC | VCC

## Page1ButtonSwitchSignal SensorCircuit[2B]

## Page2ButtonSwitchSignal SensorCircuit[2B]

## ResetOdometerButtonSwitchSIgnal SensorCircuit[2B]
