MiroslavMitrovic/DashDataDisplay_STM32/Hardware/DashDataDisplay/02_Docs/ADC/ADC_19_click_v100_Schematic.pdf

# ADC 19 Click schematic v100

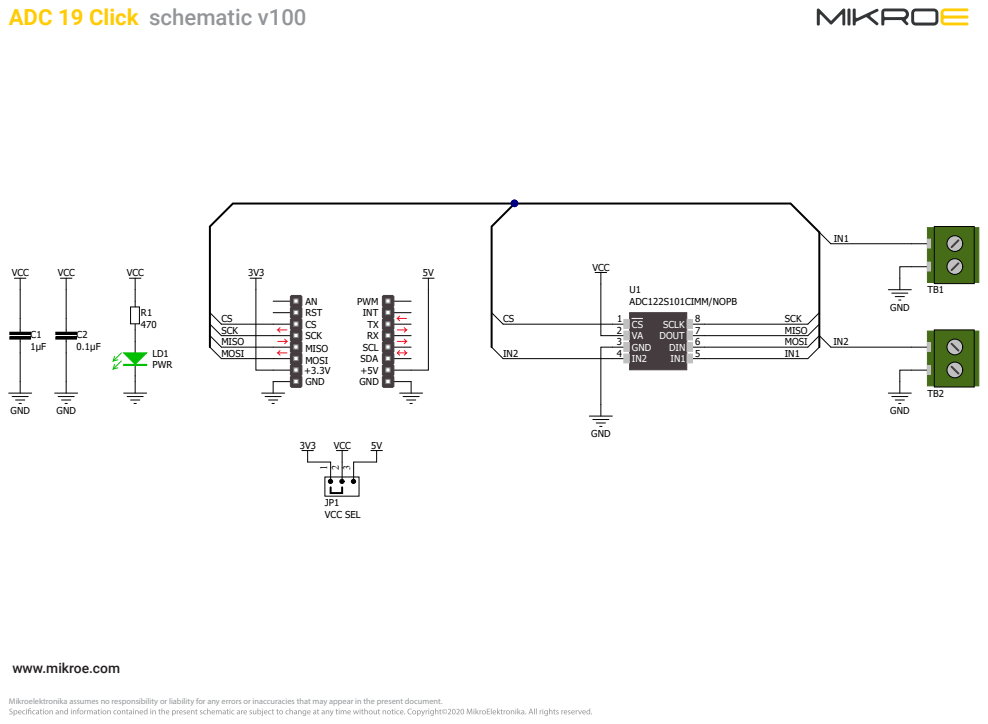
[picture p54: page 1]
VCC; LD1 PWR; AN RST CS SCK; MOSI; MISO; +3.3V GND; PWM INT; SCL SDA +5V GND; JP1 VCC SEL; SCK; GND; CS 1 VA 2 GND 3 IN2 4; SCLK 8 DOUT 7 DIN 6 IN1 5; U1 ADC122S101CIMM/NOPB

www.mikroe.com

Mikroelektronika assumes no responsibility or liability for any errors or inaccuracies that may appear in the present document.
