MiroslavMitrovic/DashDataDisplay_STM32/(list of files, drawings)

Other design files:
Hardware/DashDataDisplay/01_Parts/TestPointLib.PcbLib
Hardware/DashDataDisplay/01_Parts/TestPointLib.SchLib
Hardware/DashDataDisplay/01_Parts/ul_1N5819HW-7-F/AltiumDesigner/1N5819HW-7-F.PcbLib
Hardware/DashDataDisplay/01_Parts/ul_1N5819HW-7-F/AltiumDesigner/1N5819HW-7-F.SchLib
Hardware/DashDataDisplay/01_Parts/ul_ADC122S101CIMM-NOPB/AltiumDesigner/ADC122S101CIMMNOPB.PcbLib
Hardware/DashDataDisplay/01_Parts/ul_ADC122S101CIMM-NOPB/AltiumDesigner/ADC122S101CIMMNOPB.SchLib
Hardware/DashDataDisplay/01_Parts/ul_B82477P4334M000/AltiumDesigner/B82477P4334M000.PcbLib
Hardware/DashDataDisplay/01_Parts/ul_B82477P4334M000/AltiumDesigner/B82477P4334M000.SchLib
Hardware/DashDataDisplay/01_Parts/ul_EEUFC0J101/AltiumDesigner/EEUFC0J101.PcbLib
Hardware/DashDataDisplay/01_Parts/ul_EEUFC0J101/AltiumDesigner/EEUFC0J101.SchLib
Hardware/DashDataDisplay/01_Parts/ul_LM2575-3-3BU/AltiumDesigner/LM2575-3P3BU.PcbLib
Hardware/DashDataDisplay/01_Parts/ul_LM2575-3-3BU/AltiumDesigner/LM2575-3P3BU.SchLib
Hardware/DashDataDisplay/01_Parts/ul_LM2575-5-0BU/AltiumDesigner/LM2575-5P0BU.PcbLib
Hardware/DashDataDisplay/01_Parts/ul_LM2575-5-0BU/AltiumDesigner/LM2575-5P0BU.SchLib
Hardware/DashDataDisplay/01_Parts/ul_MAX31855KASA-T/AltiumDesigner/MAX31855KASA&plus_T.PcbLib
Hardware/DashDataDisplay/01_Parts/ul_MAX31855KASA-T/AltiumDesigner/MAX31855KASA&plus_T.SchLib
Hardware/DashDataDisplay/01_Parts/ul_MCP2551T-I-SN/AltiumDesigner/MCP2551T-ISN.PcbLib
Hardware/DashDataDisplay/01_Parts/ul_MCP2551T-I-SN/AltiumDesigner/MCP2551T-ISN.SchLib
Hardware/DashDataDisplay/01_Parts/ul_STM32F407VGT6/AltiumDesigner/STM32F407VGT6.PcbLib
Hardware/DashDataDisplay/01_Parts/ul_STM32F407VGT6/AltiumDesigner/STM32F407VGT6.SchLib
Hardware/DashDataDisplay/ADCCircuit.SchDoc
Hardware/DashDataDisplay/ButtonCircuit.SchDoc
Hardware/DashDataDisplay/CanTrcvCircuit.SchDoc
Hardware/DashDataDisplay/Connector.SchDoc
Hardware/DashDataDisplay/DashDataDisplay.PrjPcb
Hardware/DashDataDisplay/DashDataDisplayPCB.PcbDoc
Hardware/DashDataDisplay/LCDCircuit.SchDoc
Hardware/DashDataDisplay/MCUCircuit.SchDoc
Hardware/DashDataDisplay/PowerSupply.SchDoc
Hardware/DashDataDisplay/SensorCircuit.SchDoc
Hardware/DashDataDisplay/ThermoCoupleCircuit.SchDoc
