MiroslavMitrovic/DashDataDisplay_STM32/Design/Megasquirt_simplified_dash_broadcast.ini

[View_Vehicles]
HIDDEN=
ORDER=0,1,
DEFINITIONS=
COLUMNWIDTHS=250,150,
[View_Vehicle]
HIDDEN=
ORDER=0,1,
DEFINITIONS=
COLUMNWIDTHS=250,250,
[View_VehicleNetworks]
HIDDEN=3,
ORDER=0,1,2,3,4,
DEFINITIONS=1,
COLUMNWIDTHS=250,250,100,100,150,100,
[View_VehicleNetwork]
HIDDEN=
ORDER=0,1,2,3,4,
DEFINITIONS=
COLUMNWIDTHS=250,250,100,250,150,
[View_VehicleNetworkTxMessages]
HIDDEN=
ORDER=0,1,2,3,4,5,6,7,8,
DEFINITIONS=
COLUMNWIDTHS=250,250,55,100,50,100,100,100,150,
[View_VehicleNetworkSignals]
HIDDEN=
ORDER=0,1,2,3,4,5,6,7,8,9,10,11,12,13,14,15,
DEFINITIONS=
COLUMNWIDTHS=250,250,100,50,100,50,100,100,100,50,50,50,50,100,100,150,
[View_VehicleControlUnit]
HIDDEN=
ORDER=0,1,2,3,4,
DEFINITIONS=
COLUMNWIDTHS=250,250,100,250,150,
[View_VehicleGateways]
HIDDEN=
ORDER=0,1,2,
DEFINITIONS=
COLUMNWIDTHS=250,250,100,
[View_VehicleGatewaySignals]
HIDDEN=
ORDER=0,1,2,3,4,5,6,
DEFINITIONS=
COLUMNWIDTHS=250,250,250,250,250,250,250,
[View_Networks]
HIDDEN=2,
ORDER=0,1,2,3,
DEFINITIONS=1,
COLUMNWIDTHS=250,100,100,150,100,
[View_Network]
HIDDEN=
ORDER=0,1,2,3,
DEFINITIONS=
COLUMNWIDTHS=250,250,100,150,
[View_NetworkTxMessages]
HIDDEN=
ORDER=0,1,2,3,4,5,6,7,8,
DEFINITIONS=
COLUMNWIDTHS=250,250,55,100,50,100,100,100,150,
[View_NetworkTxSignals]
HIDDEN=
ORDER=0,1,2,3,4,5,6,7,8,9,10,11,12,13,14,15,16,
DEFINITIONS=
COLUMNWIDTHS=250,250,100,50,100,50,100,100,100,50,50,50,50,100,100,150,-1,
[View_NetworkNodeGroup]
HIDDEN=
ORDER=0,1,2,
DEFINITIONS=
COLUMNWIDTHS=250,100,150,
[View_Ecus]
HIDDEN=
ORDER=0,1,
DEFINITIONS=
COLUMNWIDTHS=250,150,
[View_Ecu]
HIDDEN=
ORDER=0,1,2,3,
DEFINITIONS=
COLUMNWIDTHS=250,250,100,150,
[View_EnvVars]
HIDDEN=
ORDER=0,1,2,3,4,5,6,7,8,9,
DEFINITIONS=
COLUMNWIDTHS=250,100,100,50,50,50,50,100,100,150,
[View_EnvVar]
HIDDEN=
ORDER=0,1,2,3,4,5,6,7,8,9,10,
DEFINITIONS=
COLUMNWIDTHS=250,250,100,100,50,50,50,50,100,100,150,
[View_NodeGroups]
HIDDEN=
ORDER=0,1,
DEFINITIONS=
COLUMNWIDTHS=250,150,
[View_NodeGroup]
HIDDEN=
ORDER=0,1,2,3,
DEFINITIONS=
COLUMNWIDTHS=250,250,55,150,
[View_Nodes]
HIDDEN=
ORDER=0,1,2,
DEFINITIONS=
COLUMNWIDTHS=250,100,150,
[View_Node]
HIDDEN=
ORDER=0,1,2,3,4,5,6,7,8,9,10,11,12,13,14,15,
DEFINITIONS=
COLUMNWIDTHS=250,250,100,50,50,100,100,100,50,50,50,50,100,100,150,-1,
[View_NodeTxMessages]
HIDDEN=
ORDER=0,1,2,3,4,5,6,7,
DEFINITIONS=
COLUMNWIDTHS=250,250,55,100,50,100,100,150,
[View_NodeTxMsg]
HIDDEN=
ORDER=0,1,2,3,4,5,6,7,8,9,10,11,12,13,14,15,
DEFINITIONS=
COLUMNWIDTHS=250,250,100,50,50,100,100,100,50,50,50,50,100,100,150,-1,
[View_NodeTxSignals]
HIDDEN=
ORDER=0,1,2,3,4,5,6,7,8,9,10,11,12,13,14,15,
DEFINITIONS=
COLUMNWIDTHS=250,250,100,50,50,100,100,100,50,50,50,50,100,100,150,-1,
[View_NodeRxSignals]
HIDDEN=
ORDER=0,1,2,3,4,5,6,7,8,9,10,11,12,13,14,15,
DEFINITIONS=
COLUMNWIDTHS=250,250,100,50,50,100,100,100,50,50,50,50,100,100,150,-1,
[View_NodeTxSigs]
HIDDEN=
ORDER=0,1,2,3,4,5,6,7,8,9,10,11,12,
DEFINITIONS=
COLUMNWIDTHS=250,250,50,100,100,100,50,50,50,50,100,100,150,
[View_NodeRxSigs]
HIDDEN=
ORDER=0,1,2,3,4,5,6,7,8,9,10,11,12,
DEFINITIONS=
COLUMNWIDTHS=250,250,50,100,100,100,50,50,50,50,100,100,150,
[View_Messages]
HIDDEN=
ORDER=0,1,2,3,4,5,6,7,
DEFINITIONS=
COLUMNWIDTHS=250,55,100,50,100,100,100,150,
[View_Message]
HIDDEN=
ORDER=0,1,2,3,4,5,6,7,8,9,10,11,12,13,14,
DEFINITIONS=
COLUMNWIDTHS=250,250,100,50,111,100,100,100,50,50,50,50,100,100,150,
[View_Signals]
HIDDEN=
ORDER=0,1,2,3,4,5,6,7,8,9,10,11,12,
DEFINITIONS=
COLUMNWIDTHS=250,50,100,100,100,50,50,50,50,100,100,150,100,
[View_ValueTables]
HIDDEN=
ORDER=0,1,
DEFINITIONS=
COLUMNWIDTHS=250,150,
[View_AttrDefs]
HIDDEN=6,
ORDER=0,1,2,3,4,5,
DEFINITIONS=
COLUMNWIDTHS=250,100,100,50,50,100,150,
