MiroslavMitrovic/DashDataDisplay_STM32/Testing/DashDataDisplayTests.py

import os
import platform
from enum import Enum
from math import pi
from time import sleep

import serial
import time
import can
from JDS6600 import FunctionGenerator
from CANTests import CANTesting
from RelayBoard import RelayBoard
from SignalSimulator import SignalSimulator
from PowerSupply import PowerSupply
"""Information 
    Connections to sensor simulation are following :
    - Channel 0 - Oil Pressure Sensor (function controlled)
    - Channel 1 - EGT Right (setpoint voltage of 2.4VDC)
    - Channel 2 - EGT Left  (setpoint voltage of 2.4VDC)
    - Channel 3 - Oil Temperature Sensor ((setpoint voltage of 2.5VDC)
    """


GEAR_RATIO_1:float = 5.034042
GEAR_RATIO_2:float = 3.199118
GEAR_RATIO_3:float = 2.357342
GEAR_RATIO_4:float = 1.92907
GEAR_RATIO_5:float = 1.678014
FINAL_DRIVE_RATIO:float = 3.875
DYNAMIC_ROLLING_RADIUS:float = 0.267 # in [m]
NUMBER_OF_PULSES_PER_ROTATION_VSS:int = 10
MPS_TO_KPH_RATIO:float = 3.6

OIL_PRESSURE_LIMIT_VAL: float = 3.50

class GearRatio(Enum):
    GEAR_1 = (1, 5.034042)
    GEAR_2 = (2, 3.199118)
    GEAR_3 = (3, 2.357342)
    GEAR_4 = (4, 1.92907)
    GEAR_5 = (5, 1.678014)

    def __new__(cls, gear_step:int, ratio:float):
        obj = object.__new__(cls)
        obj._value_ = gear_step
        obj.ratio = ratio
        return obj


def calculate_vehicle_speed(in_rpm:int , in_gear_ratio:float)->int:
    vehicle_speed: int = 0
    angular_wheel_speed:float = (in_rpm * 2.0 * pi * 60.0) / (in_gear_ratio * FINAL_DRIVE_RATIO)  # converted to rad/s
    vehicle_speed = int(angular_wheel_speed * DYNAMIC_ROLLING_RADIUS / 1000.0)

    return vehicle_speed

def calculate_gearshift_rpm_drop(in_current_rpm:int, in_current_gear:int)->tuple[int, int]:
    if in_current_gear < GearRatio.GEAR_1.value or in_current_gear >= GearRatio.GEAR_5.value:
        raise ValueError("RPM drop can only be calculated for upshifts from gear 1 to gear 4.")

    current_ratio:float = GearRatio(in_current_gear).ratio
    next_ratio:float = GearRatio(in_current_gear + 1).ratio
    rpm_after_shift:int = int(round(in_current_rpm * next_ratio / current_ratio))
    rpm_drop:int = in_current_rpm - rpm_after_shift

    return rpm_after_shift, rpm_drop

def calculate_downshift_rpm_rise(in_current_rpm:int, in_current_gear:int)->tuple[int, int]:
    if in_current_gear <= GearRatio.GEAR_1.value or in_current_gear > GearRatio.GEAR_5.value:
        raise ValueError("RPM rise can only be calculated for downshifts from gear 2 to gear 5.")

    current_ratio:float = GearRatio(in_current_gear).ratio
    previous_ratio:float = GearRatio(in_current_gear - 1).ratio
    rpm_after_shift:int = int(round(in_current_rpm * previous_ratio / current_ratio))
    rpm_rise:int = rpm_after_shift - in_current_rpm

    return rpm_after_shift, rpm_rise

def convert_vehicle_speed_to_signal(in_vehicle_speed:int)->int:
    wheel_circumference_m:float = 2.0 * pi * DYNAMIC_ROLLING_RADIUS
    sig_gen_frequency:int = int(
        in_vehicle_speed
        * NUMBER_OF_PULSES_PER_ROTATION_VSS
        / (wheel_circumference_m * MPS_TO_KPH_RATIO)
    )

    return sig_gen_frequency

def calculate_oil_pressure(in_rpm: int) ->float:
    """Calculate oil pressure based on simple linear function y = kx.
    return value should be in bar. """
    k: float = 0.001
    calculated_oil_pressure: float = k * float(in_rpm)
    "Clamp oil pressure due to oil pressure relief valve."
    if calculated_oil_pressure >= 3.5:
        calculated_oil_pressure = 3.5

    return calculated_oil_pressure

def calculate_voltage_oil_press_sensor_simulation(in_calculated_oil_pressure: float):
    """Bosch sensor used as a pressure sensor, and has its own characteristic BOSCH_0_261_230_365."""
    # define c0										0.1f
    # define c1										8.0e-4f
    # define SUPPLY_VOLTAGE_VALUE					5.0f
    c0: float = 0.1
    c1: float = 0.0008
    supply_voltage_val: float = 5.0

    calculated_voltage: float = supply_voltage_val * (c1 * 100.0 * in_calculated_oil_pressure + 0.1)

    return calculated_voltage

def calculate_ignition_angle_simulation(in_rpm: int) -> float:
    """
    Calculate nominal ignition advance for a Moto Guzzi V75 engine.

    Approximation based on the center of the ignition-curve tolerance band
    shown for:
        Battery voltage: 12 V
        Ambient temperature: 25 °C

    Args:
        in_rpm: Engine speed in revolutions per minute.

    Returns:
        Total ignition advance in crankshaft degrees BTDC.
    """

    if in_rpm < 0:
        raise ValueError("RPM cannot be negative")

    rpm = float(in_rpm)

    # Static/idle ignition region.
    # The low-speed negative section in the scanned graph is not clear
    # enough to model reliably, so it is clamped to 0 degrees.
    if rpm <= 1000.0:
        return 0.0

    # Advance ramp: 1000–4200 RPM
    #
    # x is normalized so that:
    #   x = 0.0 at 1000 RPM
    #   x = 3.2 at 4200 RPM
    #
    # Polynomial passes approximately through:
    #   1000 RPM ->  0.0°
    #   2000 RPM ->  9.5°
    #   3000 RPM -> 19.0°
    #   4200 RPM -> 30.5°
    if rpm <= 4200.0:
        x = (rpm - 1000.0) / 1000.0

        # Horner form:
        angle = (
            (
                0.0118371212 * x
                - 0.0355113636
            ) * x
            + 9.52367424
        ) * x

        return max(0.0, min(angle, 30.5))

    # High-speed region: 4200–10000 RPM
    #
    # Approximate center line:
    #   4200 RPM  -> 30.5°
    #   6000 RPM  -> 30.8°
    #   8000 RPM  -> 30.5°
    #   10000 RPM -> 29.5°
    #
    # Clamp above 10000 RPM to avoid polynomial extrapolation.
    limited_rpm = min(rpm, 10000.0)
    x = (limited_rpm - 4200.0) / 1000.0

    angle = (
        -0.08477011 * x
        + 0.31925287
    ) * x + 30.5

    return max(29.5, min(angle, 31.0))



def driveSimulation(in_relay_board_obj: RelayBoard):
    default_interface = "socketcan" if platform.system() == "Linux" else "pcan"
    can_interface = os.getenv("CAN_INTERFACE", default_interface)
    default_channel = "PCAN_USBBUS1" if can_interface == "pcan" else "can0"
    channel_name = os.getenv("CAN_CHANNEL", default_channel)
    bitrate = int(os.getenv("CAN_BITRATE", "500000"))
    CanTest = CANTesting()
    can_bus = None
    fg = FunctionGenerator()
    signalSimulator = SignalSimulator()
    power_supply = PowerSupply()
    fgObj = fg.FunctionGenerator_Init()
    rpm_offset_drop:tuple[int, int] = (0, 0)
    power_supply.ps_set_normal_battery_voltage()
    try:
        can_bus = CanTest.initialize_can_channel(
            channel=channel_name,
            bitrate=bitrate,
            interface=can_interface,
            auto_reset=True,
        )
        fg.FunctionGenerator_ActivateChannels(fgObj, True, False)
        fg.FunctionGenerator_SetWaveformChannel1(fgObj, "cmos")
        fg.FunctionGenerator_SetAmplitudeChannel1(fgObj, 5.0)
        fg.FunctionGenerator_SetDutyCycleChannel1(fgObj, 50.0)
        power_supply.ps_set_normal_charging_voltage()
        in_relay_board_obj.NeutralON()
        sleep(5.0)
        in_relay_board_obj.NeutralOFF()
        for i in range(1,6):
            ratio = GearRatio(i).ratio

            current_rpm: int = 0
            for j in range(180):
                current_rpm = rpm_offset_drop[0] + j * 100
                if current_rpm >= 8500:
                    break
                can_bus = CanTest.set_rpm_test(can_bus, current_rpm)
                can_bus = CanTest.send_ignAdvance_test(
                    can_bus, calculate_ignition_angle_simulation(current_rpm)
                )
                vehicle_speed = calculate_vehicle_speed(current_rpm, ratio)
                fg_frequency = convert_vehicle_speed_to_signal(vehicle_speed)
                fg.FunctionGenerator_SetFrequencyChannel1(fgObj, fg_frequency)

                signalSimulator.set_voltage_on_sensor(0, calculate_voltage_oil_press_sensor_simulation(calculate_oil_pressure(current_rpm)))
                signalSimulator.set_voltage_on_sensor(1, 2.4)
                signalSimulator.set_voltage_on_sensor(2, 2.4)
                signalSimulator.set_voltage_on_sensor(3, 4.5)
                sleep(0.25)
            if i < GearRatio.GEAR_5.value:
                rpm_offset_drop = calculate_gearshift_rpm_drop(current_rpm,i)
            print("Upshift Performed!")
        downshift_rpm_threshold:int = 3000
        rpm_offset_rise:tuple[int, int] = (current_rpm, 0)
        #sleep(500)
        for i in range(GearRatio.GEAR_5.value, GearRatio.GEAR_1.value - 1, -1):
            ratio = GearRatio(i).ratio
            power_supply.ps_set_low_charging_voltage()
            current_rpm: int = 0
            for j in range(180):
                current_rpm = rpm_offset_rise[0] - j * 100
                if current_rpm <= downshift_rpm_threshold:
                    break
                can_bus = CanTest.set_rpm_test(can_bus, current_rpm)
                can_bus = CanTest.send_ignAdvance_test(
                    can_bus, calculate_ignition_angle_simulation(current_rpm)
                )
                vehicle_speed = calculate_vehicle_speed(current_rpm, ratio)
                fg_frequency = convert_vehicle_speed_to_signal(vehicle_speed)
                fg.FunctionGenerator_SetFrequencyChannel1(fgObj, fg_frequency)
                signalSimulator.set_voltage_on_sensor(0, calculate_voltage_oil_press_sensor_simulation(calculate_oil_pressure(current_rpm)))
                signalSimulator.set_voltage_on_sensor(1,2.4)
                signalSimulator.set_voltage_on_sensor(2, 2.4)
                signalSimulator.set_voltage_on_sensor(3, 4.5)
                sleep(0.25)

            if i > GearRatio.GEAR_1.value:
                rpm_offset_rise = calculate_downshift_rpm_rise(current_rpm,i)
            print("Downshift Performed!")

    finally:
        power_supply.ps_set_low_battery_voltage()
        sleep(10)
        in_relay_board_obj.NeutralON()
        fg.FunctionGenerator_SetFrequencyChannel1(fgObj, 0)
        fg.FunctionGenerator_ActivateChannels(fgObj, False, False)
        CanTest.close_bus(can_bus)
        signalSimulator.set_voltage_on_sensor(0,0.5)
        signalSimulator.set_voltage_on_sensor(1, 0.0)
        signalSimulator.set_voltage_on_sensor(2, 0.0)
        signalSimulator.set_voltage_on_sensor(3, 0.0)
def main():
    relayBoard = RelayBoard()
    power_supply = PowerSupply()
    power_supply.ps_set_normal_battery_voltage()
    time.sleep(3)
    relayBoard.KL30_ON()
    time.sleep(5)
    relayBoard.KL15_ON()
    time.sleep(1)
    driveSimulation(in_relay_board_obj=relayBoard)
    #HiBeamTest()
    #LowBeamTest()
    #HazardWarningTest()
    relayBoard.KL15_OFF()
    time.sleep(7)
    relayBoard.KL15_ON()
    time.sleep(10)
    relayBoard.KL15_OFF()
    time.sleep(5)
    relayBoard.KL30_OFF()



while True:
    main()
