MiroslavMitrovic/DashDataDisplay_STM32/(commit log)

2022-12-26 Initial Architecture, Use case Diagram created
2022-12-27 Added new use case in UseCaseDiagram
2023-01-09 Documentation : Architecture update, HW Filter Circuit Layout Diagram added
2023-01-17 Updated HW filter Circuit and SRS
2023-01-18 Added NTC HW circuit Components and NTC params
2023-04-25 Added Pressure sensor interfacing circuit to the Architecture and to SRS
2024-06-19 Initial Hardware Design
    [1-776200-5.stp, 17762005.psm, 1N5819HW-7-F.PcbLib, 1N5819HW-7-F.SchLib, 1N5819HW-7-F_DIO.step, 21-0041B_8_MXM.step, 87527-2.stp, ADC122S101CIMMNOPB.PcbLib]
2024-06-19 HW updates and gerber files
    [ADCCircuit.SchDoc, Assembly Testpoint Report for DashDataDisplayPCB.csv, CanTrcvCircuit.SchDoc, DashDataDisplay.PrjPcb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]
2024-11-01 Added schematics in PDF format
2024-11-02 Architecture and Requirements update-Added TurnSignal and Headlight Indication
    [SenzorPritiskaKalibracija.xlsx]
2024-11-10 Added changes to ADC to include ADC IC,updated HW layout to the current PCB one
2025-04-06 Added PowerIC Sourcecode
2026-05-30 Updates to sensor simulator
2026-09-19 Updates to testing, added Udev scripts for devices
